clevercoffee/clevercoffee-docs/public/3d-designs/readme.md

Tipps zum Drucken:

1. Gehäuse auf dem Kopf liegend drucken (um 180° in X oder Y drehen)
2. Ein halbwegs Temperaturstabiles Filament verwenden (normales PLA ist etwas knapp)
3. Optimiert für eine 0,4mm Düse und eine Schichthöhe von 0,2mm
4. Für einen schönen optischen Touch in der ersten Schicht conzentrischen Infill verwenden

Die Magneten mit 6mm Durchmesser (2x 1mm und 1x 2mm dick) mit einem guten Kleber einkleben - Sekundenkleber hat sich als ungeeignet herausgestellt. 

Nach der [Einbauanleitung.pdf](./Einbauanleitung.pdf) zusammenbauen und montieren.
