clevercoffee/clevercoffee-docs/src/content/de/intro/requirements.mdx

---
title: Anforderungen an dich
---

# Anforderungen an dich

<Caution lang={props.params.lang} />

## Zentrale Fragen

### Traue ich mir zu mit 230V Spannung zu arbeiten? Ist mir die Gefahr bewusst?

Ihr verändert bzw. erweitert mit dem Einbau die werksseitige 230V-Verkabelung der Maschine. Damit habt ihr immer das Risiko eines lebensgefährlichen Stromschlags oder Feuer, sei es durch Fehler beim Einbau, nicht ausreichend isolierte Kontakte, brüchige Isolierung bei älteren oder nicht ausreichend hitzebeständigen Kabeln, etc. **Das muss euch bewusst sein, ihr macht den Einbau auf eigenes Risiko!**

Wenn ihr das nicht fachlich richtig umsetzen könnt oder unsicher seid, sucht euch bitte jemanden vom Fach! Für jemanden mit Grundwissen in Elektrotechnik ist der Einbau kein Problem. Wir helfen bei konkreten Fragen gerne weiter, aber die Verantwortung für euren Umbau können und wollen wir euch nicht abnehmen!

Eine eventuell noch bestehende Garantie bei neueren Maschinen ist durch den Einbau selbstverständlich erloschen, das muss euch ebenfalls bewusst sein.

### Habe ich Lust dazu, mich näher mit meiner Maschine und mit der PID-Steuerung zu beschäftigen?

Mit der PID-Steuerung erhöht ihr die Komplexität eurer Maschine. Ihr hab jetzt mehr Möglichkeiten, für den Kaffeegenuss relevante Parameter zu verändern als vorher. Das kann viel Freude machen, kann aber auch überfordern, sofern man beim ausprobieren nicht planvoll vorgeht.

Wir haben für die gängigen Einkreiser-Espressomaschinen bereits gut funktionierende Parameter-Setups verfügbar, daher werden sich die Ergebnisse in der Tasse verbessern, auch wenn ihr „nur“ den PID installiert und die Standardparameter aufspielt.

Ihr kommt aber zu noch besseren Ergebnissen, wenn ihr etwas besser Bescheid wisst, was der PID tut und warum er das tut. Es lohnt sich die Zeit zu investieren um a) seine Maschine besser kennen zu lernen und b) die Grundfunktion des PIDs zu verstehen. Außerem lernt man auch eine Menge darüber, wie sich der Geschmack von Espresso bei Anpassung verschiedener Parameter verändert.
