clevercoffee/clevercoffee-docs/src/content/en/hardware/index.md

---
title: Hardware
parent: EN - Manual
asIndexPage: true
---

# Hardware

This part contains the hardware related aspects of the PID, including the test assebly, circuit diagrams and final installation.
