clevercoffee/clevercoffee-docs/src/content/de/index.mdx

## Handbuch (deutsch)

Dies ist das deutsche Handbuch für die Umsetzung des CleverCoffee Projektes. Dieses Handbuch deckt alle notwendigen Schritte für den Einbau und die Konfiguration ab.

Es ist sehr empfehlenswert zuerst die einleitenden Artikel zu lesen. Dadurch erfährt man, welche Anforderungen erfüllt sein müssen, um eine Maschine mit einem PID zu ergänzen. Außerdem wird beschrieben was das vorgestellte System kann (und was es nicht kann).

Der erste konkrete Schritt beginnt mit der Bestellliste. Je nach Ausbaustufe und bereits vorhandener Ausstattung, setzt sich diese unterschiedlich zusammen. Während ihr auf die Hardware wartet, könnt ihr damit beginnen die Software aufzusetzen. Danach wird beides vereint und eingebaut. Nach erfolgreichem Test findet ihr im letzten Abschnitt noch eine Vielzahl von Anpassungsmöglichkeiten, damit auf keinen Fall lange Weile aufkommt.

Mehr zum Projekt findet ihr auf der [CleverCoffee Website](https://clevercoffee.de/).

## Kontakt

Schaut am besten auf unserem [Discord](https://discord.com/invite/Kq5RFznuU4) vorbei.
