clevercoffee/clevercoffee-docs/src/content/de/customization/index.md

---
title: Konfiguration & Anpassung
asIndexPage: true
---

# Konfiguration & Anpassung

In diesem Abschnitt gehen wir auf die Detail ein. Hier seht ihr, welche PID Parameter angepasst werden können und welchen Einfluss die Anpassungen haben. Dieses Kapitel ist damit insbesondere nach dem erfolgreichen Einbau interessant, wenn es nur noch um das Feintuning geht.
