clevercoffee/clevercoffee-docs/src/content/de/intro/index.md

---
title: Einführung
asIndexPage: true
---

# Einführung

In diesem Abschnitt werden die Grundlagen der Funktionen und Möglichkeiten des PIDs und der restlichen Features beschrieben. Es ist damit ein guter Start in das Thema und beschreibt auch nötige Voraussetzungen und Warnhinweise. Zudem wird beschrieben welche Maschinen bereits erfolgreich einen PID-Ausbau erhalten haben und wie der Trockenaufbau aussieht.
