clevercoffee/clevercoffee-docs/src/content/de/intro/intro.md

---
title: Einleitung PID System
---

# Einleitung PID System

## Was bringt mir eine PID-Steuerung?

Eine PID-Regelung ermöglicht es deiner Espressomaschine die Temperatur des Brühwassers sehr viel exakter und konstanter zu regeln als das mit den werksseitig verbauten Bimetall-Thermostaten möglich ist.

Die gängigen Thermostate haben eine Schwankung der durch sie geregelten Temperatur von bis zu 10°, auch Hysterese genannt. Grob gesagt bedeutet das: eure Maschine heizt hoch, bis der Thermostat seine Schalttemperatur erreicht hat und den Strom zur Heizung unterbricht. Gleichzeitig leuchtet die Lampe eurer Maschine auf (bzw. die Heizlampe wird ausgeschaltet) und zeigt euch Brühbereitschaft an.

Jetzt verliert der Kessel eurer Maschine je nach Ausführung mehr oder weniger schnell Wärmeenergie durch Abstrahlung an die Umgebung. Dies geschieht so lange, bis der Anschaltpunkt des Thermostaten erreicht ist und er den Stromkreis zur Heizung wieder aktiviert. Die Brühlampe eurer Maschine erlischt und die Maschine heizt wieder hoch bis zum Erreichen des Abschaltpunktes.

Zwischen diesen beiden Temperaturpunkten leuchtet die ganze Zeit die Brühbereitschaftslampe eurer Maschine. Die wirkliche Brühtemperatur des Wassers kann sich aber entweder ganz unten nah beim Anschaltpunkt des Thermostaten befinden, oder ganz oben kurz vor dem Abschaltpunkt, oder irgendwo im Bereich dazwischen.

Neben guten Bohnen, einer guten Mühle, der richtigen Dosis und dem Mahlgrad ist beim Espresso brühen die Temperatur des Brühwassers einer DER entscheidenden Faktoren für den Geschmack des Kaffees. Schon eine Differenz von 1-2° kann den Unterschied zwischen zu sauer (zu kalt), zu bitter (zu heiß) oder lecker (genau richtig) bedeuten. Welche Temperatur ideal ist hängt neben dem eigenen Geschmack jeweils stark von der verwendeten Bohne und der Röstung ab.

Eine herkömmliche Maßnahme ist das sogenannte Temperatursurfen, eine relativ aufwändige und unsichere manuelle Methode der Temperaturkontrolle, die viel schätzen und immer wieder ausprobieren erfordert.

Viele Nutzer sind davon irgendwann genervt, wir waren es genauso.

Die Lösung für kleinere Einkreiser-Maschinen ist es, den Thermostaten mit einem PID-Regler zu ersetzen. Dieser regelt die Brühtemperatur mit einer Schwankung von deutlich unter 1°, unser System kann auf bis zu 0,1° genau regeln. Man muss nicht mehr an der Maschine bleiben um den richtigen Zeitpunkt zum Bezug abzuwarten, der richtige Zeitpunkt ist ab jetzt einfach immer sobald die Maschine einmal durchgeheizt ist!

## Was kann unser System?

Folgende Eckdaten zeichnen unseren DIY PID aus:

- Regelung der Brühtemperatur mit einer Genauigkeit von bis zu +/- 0,1°
- Steuerung der Brühzeit inkl. Pre-Infusion in der Ausbaustufe „Vollausbau“ möglich
- Bezug nach Gewicht
- Wasserstandmonitor
- Bedienung und Konfiguration über eingebautes Webinterface
- Datenmonitoring alternativ über Grafana (Webbasiert) und MQTT (IoT) möglich
- Updates der Software sind drahtlos über WLAN möglich
- Unsere Software ist OpenSource: für euch kostenfrei und auf persönliche Anforderungen anpassbar
- Geringer Platzbedarf, passt problemlos in die meisten kleineren Espressomaschinen
- Die serienmäßige Verkabelung der Maschine bleibt erhalten und wird nur erweitert. Die Maschine kann nach dem Umbau problemlos wieder zurückgerüstet werden
- Aktive User-Community im Projektchat mit schnellem Support

Anregungen zur Weiterentwicklung der Software werden von uns gerne aufgenommen. User-Input ist immer willkommen und bringt das Projekt weiter!

## Universell – Umgebaute Maschinentypen

Entwickelt wurde unser System ursprünglich an einer Rancilio Silvia, es ist aber universell einsetzbar. Bislang haben unsere User die folgenden Maschinen erfolgreich umgebaut:

- Rancilio Silvia V1 – V4
- Rancilio Silvia E(co) V5 & V6
- Gaggia Classic (9303) / Classic Pro (9480) / New Classic (9403)
- Lelit PL41 / PL42
- La Pavoni EPL / Saeco Aroma
- E61 Einkreiser (Bazzar A1 Livello, Fiorenzato Colombina)
- E61 Zweikreiser (Profitec Pro500)
- Quick Mill Retro (0835) & Orione (3000)

## Aufbau / Unterschiede PID Only vs. Vollausbau

Grundsätzlich besteht unser PID-Regler aus den folgenden Komponenten:

| ID  | Erklärung |
| --- | --- |
| 1 | Mikrocontroller ESP32 (DevKitC V4) |
| 2 | Temperatursensor TSIC 306 |
| 3 | Solid State Relais (SSR) |
| 4 | Netzteil zur Stromversorgung |
| 5 | Display SSD1306 (empfohlen, aber optional) |

Trockenaufbau

Es gibt zwei verschiedene Ausbaustufen unseres Systems: PID Only und den erweiterten Vollausbau.

## Ausbaustufen

Es gibt 2 Ausbaustufen: "PID Only" und den "Vollausbau".
Mit der Zeit haben sich dazu Ergänzungen ergeben, die in der nachfolgenden Grafik dargestellt sind.
Die Grenzen sind fließend, da auch beim "PID Only" nun zur Anzeige des Bezugsgewicht die Waage genutzt werden kann oder die Erkennung des Brühschalters per Optokoppler eine genaue Anzeige der Brühzeit ermöglicht.

Trockenaufbau

## Grundversion (PID Only)

Die Grundversion ist ein klassischer PID-Regler: der Temperatursensor nimmt die aktuelle Temperatur des Kessels auf (Input) und gibt den Wert an die PID-Software auf den Mikrocontroller weiter. Diese gibt dann das Regler-Signal (Output) an das SSR aus, welches die Heizung eurer Maschine aktiviert bzw. deaktiviert.

Damit ist eine exakte Regelung der Brühtemperatur auf euren Wunschwert durch die PID-Software möglich, die restliche Bedienung eurer Maschine bleibt unangetastet. MQTT, Displayausgabe und Webinterface ist auch mit PID Only möglich.

## Erweiterung der Grundversion (PID Only+)

Um bei einem Bezug die Temperatur besser zu regeln, kann ein zusätzlicher Sensor (Optokoppler) verbaut werden, um den Brühschalter abzufragen. Damit kann während des Bezugs auf dem Display die genaue Brühzeit angezeigt werden.

## Vollausbau

Beim Vollausbau gehen wir einen Schritt weiter und überlassen die Ansteuerung der Pumpe und des Magnetventils ebenfalls der Software. Dadurch könnt ihr in der App drei Zeitintervalle vorgeben:

- Pre-Infusion: die Pumpe baut Druck auf (geringer als der Brühdruck) und das Magnetventil gibt das Brühwasser auf den Siebträger

- Pause: die Pumpe pausiert, der aufgebaute Druck bleibt aber durch das geschlossene Magnetventil im Siebträger bestehen. So wird der Kaffeepuck gleichmäßig durchfeuchtet und so kann etwaiges Channeling reduziert werden.

- Brühzeit: jetzt startet der „normale“ Bezug mit der von dir festgelegten Bezugszeit, z. B. 25 Sekunden und vollem Druck. Je nach Bohnensorte und persönlichem Geschmack kann eine kürzere oder längere Bezugszeit den Geschmack des Espressos positiv beeinflussen.

Beim Vollausbau ändert sich die Bedienung eurer Maschine auch etwas: der Brühschalter, mit dem ihr bislang den Bezug gestartet und auch wieder gestoppt habt, dient nun nur noch als Taster, der den automatisierten Bezug startet. Gestoppt wird der Bezug durch die Software, auch wenn der Schalter noch auf ON steht.

Unsere Empfehlung, basierend auf unseren eigenen Erfahrungen und denen der bislang mehr als 250 User des PIDs, lautet ganz klar, zuerst die Grundversion PID Only umzusetzen. Damit ist die größte geschmackliche Verbesserung im Vergleich zum vorherigen Serienzustand eurer Maschine zu erwarten. Der Vollausbau ist darauf aufbauend eine Erweiterung der Möglichkeiten, aber gleichzeitig auch ein komplexerer Umbau.

## Vollausbau Plus

Bei diesem Ausbau bleibt kein Wunsch mehr offen, da das Bezugsgewicht nun die Bezugsdauer steuert.
Auch ist eine Drucküberwachung mittel Drucksensor möglich (aber kein Pressure Profiling).
