clevercoffee/clevercoffee-docs/src/content/de/pcb/index.md

---
title: Platinen
asIndexPage: true
---

# Platinen

Um den Einstieg in CleverCoffee zu vereinfachen haben wir Platinen (PCBs) entwickelt auf die ein ESP32 Entwicklerboard aufgesteckt werden kann.
Die Platine stellt euch dann alle benötigten Anschlüsse bereit und passt zur Belegung der GPIOs in unserer Software.

Die Entwicklung findet in einem extra Repository statt. Ihr findet dieses hier: [CleverCoffee Hardware Repository](https://github.com/rancilio-pid/clevercoffee-hardware).

In diesem Abschnitt befinden sich alle Informationen zu den Platinen und den verschiedenen Revisionen.
