clevercoffee/clevercoffee-docs/src/content/de/software-part-I/index.md

---
title: Software
asIndexPage: true
---

# Software

## Einleitung

In diesem Kapitel wird beschrieben wie der Code auf den Mikrocontroller (ESP32 oder ESP8266) geladen wird. Damit könnt ihr loslegen, sobald ihr den Mikrocontroller zur Hand habt (weitere Teile werden hierfür noch nicht benötigt). Für einen Test sollte dann zumindest der Temperatursensor angeschlossen werden.
