clevercoffee/clevercoffee-docs/src/content/en/intro/index.md

---
title: Introduction
parent: EN - Manual
asIndexPage: true
---

# Introduction

This section covers the basics, functionality as well as options of the PID. It will get you grounded in the topic and covers prerequisites as well as warnings. It provides information about models of espresso machines that have already been modified and how the general setup looks like.
