clevercoffee/clevercoffee-docs/src/content/en/software-part-I/index.md

---
title: Software
parent: EN - Manual
asIndexPage: true
---

# Software

## Introduction

In this section, all steps are described on how to load the code onto the microcontroller (ESP32 or ESP8266). With that, you can already get started without having the other hardware parts at hand. You can start with this part while waiting for your ordered parts to be delivered ;)
