clevercoffee/clevercoffee-docs/src/content/de/bauberichte/lelit-pl41em.md

---
title: Lelit PL41EM / PID-Only
---

# Lelit PL41EM / PID-Only

<!-- ## Bestellliste

*todo* -->

<!-- markdown-link-check-disable -->

## Trockenaufbau

Auf dem Bild unten seht ihr den von mir vorbereiteten Trockenaufbau, den ich vor dem Einbau getestet habe. Wie hier im Handbuch ausgiebig erklärt, habe ich die Terminals an die Platine des NodeMCU gelötet, die Software aufgespielt, hitzebeständige Litzen an den Temperatursensor gelötet und mit Schrumpfschlauch versehen, das Display (vorläufig) angeschlossen, das Netzteil vorbereitet und das Relais angeschlossen und getestet. Wichtig war für mich vor dem Einbau, dass die Softwareupdates over-the-air funktionieren, sodass ich bei zukünftigen Updates die Maschine öffnen muss. Als das alles zufriedenstellend funktionierte, habe ich mich an den Einbau in die Maschine gemacht.



## Einbauschritte

### Vorbereitung der Maschine

Zuerst muss die Maschine natürlich vom Strom getrennt und der Wassertank entfernt werden.



Da die Maschine insgesamt recht kompakt und im Inneren dementsprechend wenig Platz für alle PID-Komponenten ist, habe ich mich entschieden, den leeren Raum zwischen Wassertank und Front der Maschine zu verwenden und alle Komponenten dort mit doppelseitigem wärmeleitenden Klebeband zu befestigen. Der Vorteil dieser Anbringung ist, dass die Komponenten weit genug entfernt vom warmen Kessel liegen und ihre Abwärme über die metallische Front der Maschine abgeben können. Der Nachteil allerdings ist, dass eine spätere Fehlersuche nur sehr schwierig ist, da man die Komponenten kaum erreicht und man schlimmstenfalls Platine, Relais und Netzteil komplett ausbauen muss, um eventuell auftretende Fehler zu finden.



Um an das Innere der Maschine zu gelangen, müssen die beiden Schrauben links und rechts neben der Aussparung für die Wasserschläuche herausgedreht und die Tassenablage vorsichtig abgenommen werden. Dabei sollte man natürlich darauf achten, dass die Schläuche nicht durch die teilweise sehr scharfen Metallkanten beschädigt werden.



Ist die Tassenablage entfernt, habt ihr das Innere der Maschine mit Pumpe, Kessel, Elektrik, etc. vor euch und der eigentliche Einbau kann beginnen.



### Netzteil

Um das System mit Strom zu versorgen, müssen Außen-, Neutral- und Schutzleiter der Maschine angezapft werden. Zur besseren Übersicht habe ich mir analog zu den Standardfarben hitzebeständige 1,5mm²-Litzen in braun, blau und grün-gelb gekauft und damit das Netzteil in der Maschine versorgt.




#### Schutzleiter

Die Erdung ist innerhalb der Maschine direkt am Kessel zu finden.


Mit einer Ratsche und einem Inbusbit plus Verlängerung habe ich diese Schraube und die dazu passende Mutter am Brühkopf gelöst und einen passenden Kabelschuh auf die grün-gelbe Litze gecrimpt.




Diesen Kabelschuh habe ich dann auf die Schraube geschoben und sie wieder am Kessel befestigt.



#### Außen- und Neutralleiter

Ich habe mich entschieden, die Stromversorgung für das PID-System hinter dem Hauptschalter der Maschine abzugreifen, sodass das System mit der Maschine an- und wieder ausgeschaltet wird. Die Ausgänge des Schalters sind die beiden _unteren_ Anschlüsse. Um sie anzuschließen habe ich im ersten Schritt Kabelschuhe an eine blaue und eine braune 1,5mm²-Litze gecrimpt.

Da die Ausgänge des Schalters als Flachstecker ausgeführt sind, habe ich sie jeweils mit Flachsteckerverteilern versehen und die zum Netzteil führenden Litzen sowie die Stecker, die ursprünglich angeschlossen waren und den Rest der Maschine mit Strom versorgen, aufgesteckt.






#### Kürzen der Litzen

Im letzten das Netzteil betreffenden Schritt habe ich die drei zum Netzteil führenden Litzen auf die endgültige Länge eingekürzt, mit blauen Kabelschuhen versehen und am Netzteil angeschlossen.






#### Test und Prüfen der Ausgangsspannung

Um den Anschluss des Netzteils zu testen, habe ich die Kaffeemaschine wieder angesteckt, angeschaltet, und mit dem Multimeter die Spannung am Ausgang des Netzteils gemessen. Solltet ihr es nicht schon vorher im Rahmen eures Trockenaufbaus überprüft haben, könnt ihr die Ausgangsspannung des Netzteils mithilfe des Drehpotentiometers auf 5V einstellen.




### Display

Um das Display anzuschließen, habe ich mir von einer Rolle Flachbandkabel die passende Länge (ca. 30--40cm) abgetrennt, vier zusammenhängende Litzen abgelöst, jeweils an einem Ende mit Dupont-Buchsen versehen und diese vier Buchsen in das passende Vierergehäuse geschoben. Hierbei sollte man natürlich auf die korrekte Reihenfolge achten, sodass man sich nicht mit Kabeldrehern an der Platine behelfen muss.







### Vorbereitung Relais

Um das Relais vorzubereiten, müssen in diesem Schritt lediglich die Litzen (ich habe mich für schwarz und blau entschieden) eingekürzt und mit blauen Flachsteckern versehen werden. Der Verteiler, der auf dem Bild an der schwarzen Litze zu sehen ist, ist im Einbau nicht nötig.




### Anbringen der Komponenten in der Maschine

Um die Komponenten in der Maschine anzubringen, habe ich zuerst doppelseitiges, wärmeleitendes Klebeband an Relais und Netzteil angebracht.




Da diese Art des Einbaus im Freiraum zwischen Wassertank und Front der Maschine es kaum erlaubt, nach dem Anbringen noch Kabel an- oder abzuschließen oder überhaupt gut Relais, NodeMCU oder Netzteil zu erreichen, sollte man sich an dieser Stelle sicher sein, dass alle Verbindungen stabil sind, es gar keinen bis kaum Kabelsalat gibt und dass der Aufbau zufriedenstellend funktioniert. Wenn man auf Nummer sicher gehen will, kann man natürlich an dieser Stelle noch einmal einen Test vornehmen, die Espressomaschine anschalten, prüfen, ob das Display des NodeMCU sich anschaltet und ob die Messung des Temperatursensors sinnvoll erscheint.

Ist man sich sicher, dass alles funktioniert, können die Komponenten jetzt in sicherem Abstand voneinander in den Freiraum geklebt und die Kabel verlegt werden. Das Displaykabel sollte natürlich (vorerst) nach außen führen, die Anschlüsse des Relais und der Temperatursensor nach innen in die Maschine.





### Thermostat und Temperatursensor

Um den Temperatursensor am Kessel zu fixieren, habe ich zuerst die am 94°-Thermostat angeschlossenen Kabel gelöst und es mit einem 17er-Schlüssel ausgeschraubt. Darunter kommt ein M4-Gewinde zum Vorschein.





In dieses Gewinde habe ich erst einmal locker eine M4-Schraube mit einer Unterlegscheibe geschraubt. Um den Temperatursensor selbst vorzubereiten, habe ich großzügig wärmeleitenden Kleber auf eine Unterseite gegeben, ihn unter die Unterlegscheibe geschoben und vorsichtig solange die Schraube angezogen, bis der Sensor nicht mehr verrutschte. Dafür bietet es sich an, sich noch ein, zwei helfende Hände zu suchen, um gleichzeitig Sensor, Unterlegscheibe und Schraubendreher unter Kontrolle zu halten. Es ist natürlich sehr wichtig, die Schraube nicht zu fest anzuziehen, um den Sensor nicht zu beschädigen.




### Anschluss Relais

Der Anschluss des Relais besteht nun einfach daraus, die beiden vom Thermostat abgesteckten Buchsen (eine ist eine einfache Buchse, die andere ist ein Verteiler) auf die Flachstecker der Ausgangslitzen des Relais zu stecken. Welchen Ausgang des Relais man mit welchem Stecker verbindet, ist an dieser Stelle egal, da das Relais auf Anweisung unabhängig von irgendwelcher Polung einfach eine Verbindung zwischen seinen beiden Ausgängen herstellt.



### Einbau Schutzplatte

Wenn alles angeschlossen und man sich vom korrekten Funktionieren des ganzen Systems überzeugt hat, kann die Tassenablage wieder vorsichtig auf die Maschine gesetzt werden.



Um die nun im inneren der Maschine frei liegende Elektronik zu schützen, habe ich eine [Abdeckplatte](/../../3d-designs/lelit_schutzplatte.scad)[^1] entworfen und gedruckt. Sie lässt sich mittels der Schrauben der Tassenablage fixieren, verdeckt die Elektronik und schützt sie vor eventuellen Wasserspritzern beim Befüllen oder vor Stößen beim Einsetzen des Wassertanks. Leider hat mein 3D-Drucker beim ersten Druck der Platte kein schönes Ergebnis erzeugt, sodass ich die Platte mit ein wenig Gaffer-Tape stabilisieren musste. Gedruckt habe ich die Platte aus PET-G, sodass sie gegenüber einem Druck mit PLA noch ein wenig temperaturunempfindlicher ist.



Wie der Blick von oben in die fertige Maschine zeigt, verschwindet die Elektronikkomplett hinter der Abdeckplatte und es ist noch mehr als genug Platz für den Wassertank.




Um das Display bis zur Umsetzung einer dauerhaften Lösung zu schützen, habe ich dafür ein einfaches Gehäuse gedruckt.

## PID-Werte

Mit den von mir gewählten PID-Werten bin ich noch nicht komplett zufrieden, da es z.B. nach einem kurzen Bezug noch zu recht starken Überschwingern kommt. Für den Kaltstart habe ich die Werte *50/125/0* gewählt, für den anschließenden Betrieb *20/600/0*.

[^1]: Zur Verwendung des [OpenSCAD](https://openscad.org/)-Designs ist noch dieses [Library](https://github.com/openscad/MCAD) notwendig.

<!-- markdown-link-check-enable-->
