clevercoffee/clevercoffee-docs/src/content/de/hardware/index.md

---
title: Hardware
asIndexPage: true
---

# Hardware

In diesem Abschnitt werden alle Hardware-Aspekte behandelt. Dies umfasst den Trockenaufbau, die verschiedenen Schaltpläne und den konkreten Einbau.
