clevercoffee/clevercoffee-docs/public/schaltplan/OnlyPIDRancilio.png

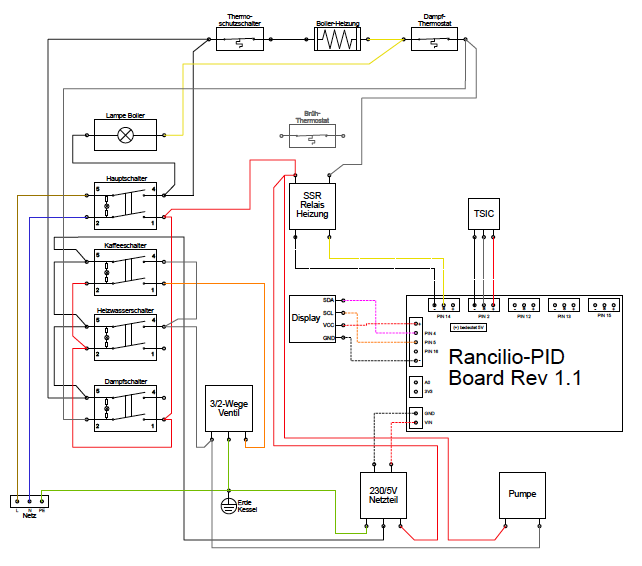
public/schaltplan/OnlyPIDRancilio.png
