clevercoffee/clevercoffee-docs/public/schaltplan/OrginalSchaltplanRancilio.png

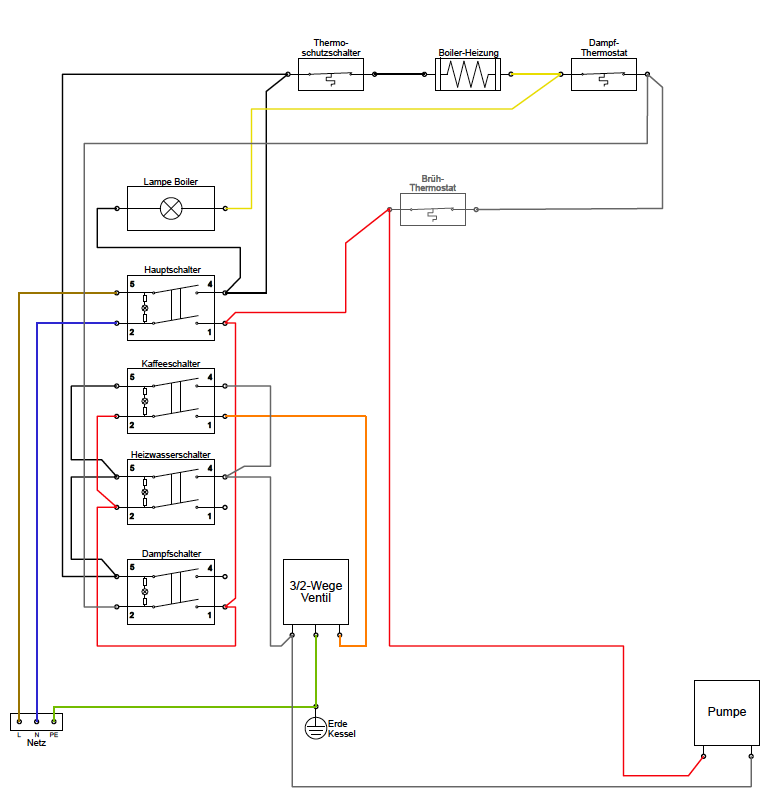
public/schaltplan/OrginalSchaltplanRancilio.png
