clevercoffee/clevercoffee-docs/public/schaltplan/QM_Electrica_Scheme_Quickmill_3000.gif

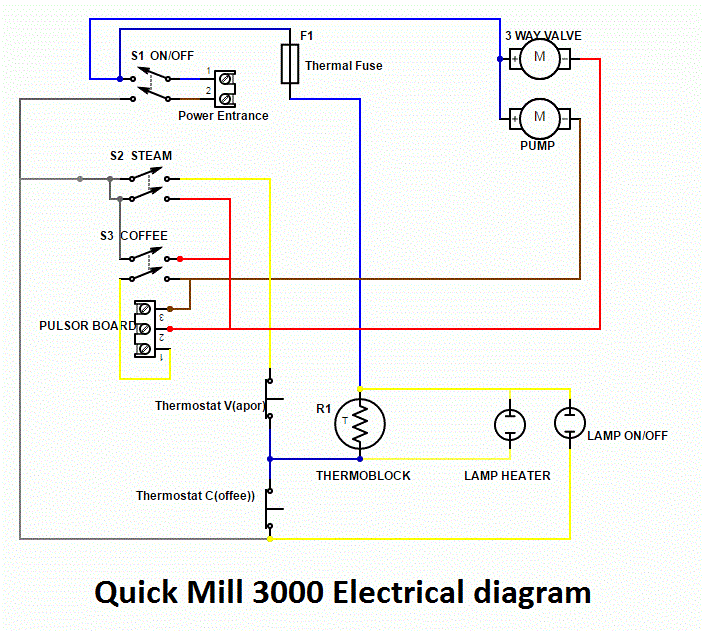
public/schaltplan/QM_Electrica_Scheme_Quickmill_3000.gif
