clevercoffee/clevercoffee-docs/public/schaltplan/QM_Electrica_Scheme_Quickmill_3000_mod1.jpg

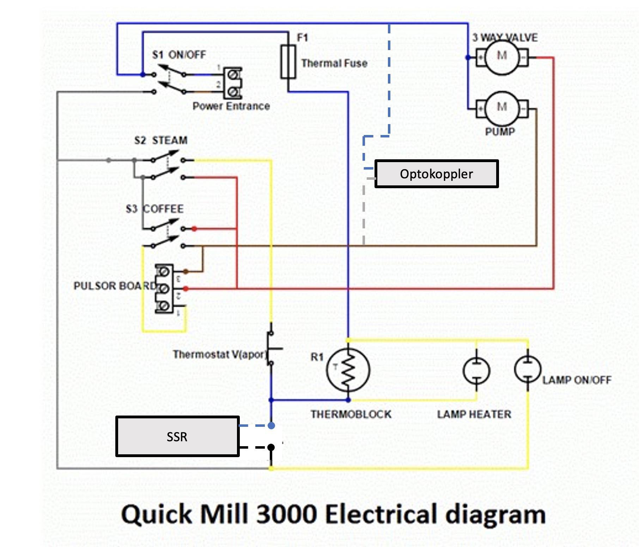
public/schaltplan/QM_Electrica_Scheme_Quickmill_3000_mod1.jpg
