clevercoffee/clevercoffee-docs/public/schaltplan/VollausbauRancilio.png

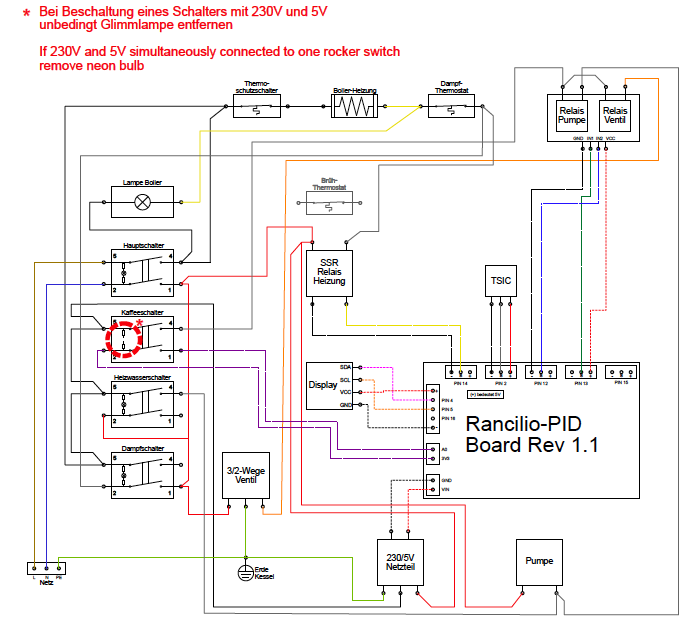
public/schaltplan/VollausbauRancilio.png
