clevercoffee/clevercoffee-docs/public/wp-content/uploads/2021/01/App.jpg

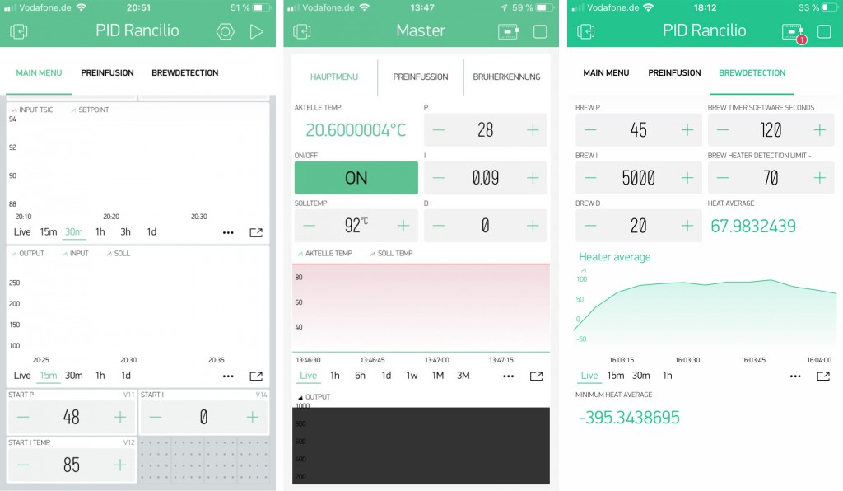
public/wp-content/uploads/2021/01/App.jpg
