clevercoffee/clevercoffee-docs/public/wp-content/uploads/2021/01/Board.jpg

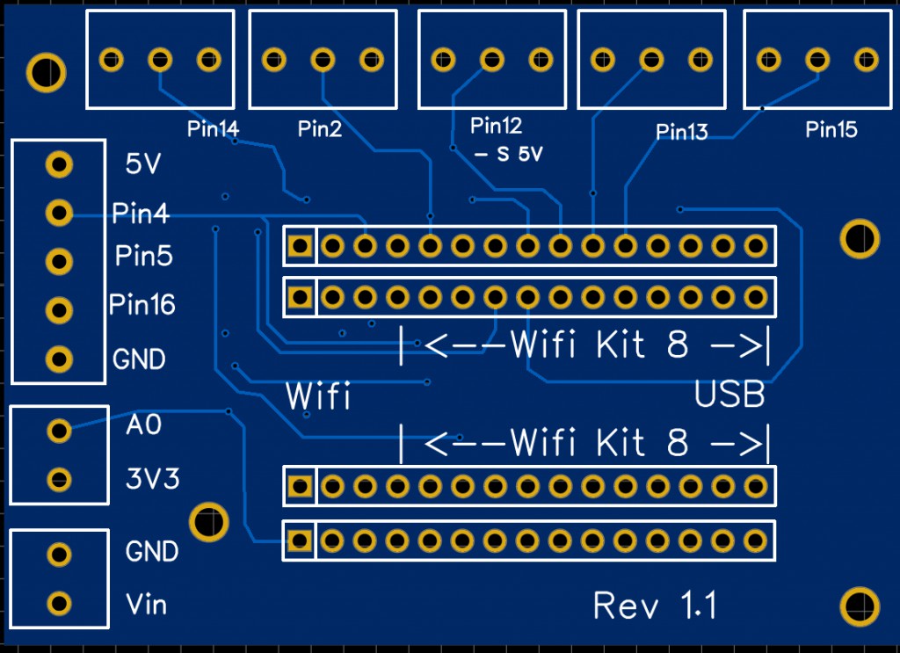
public/wp-content/uploads/2021/01/Board.jpg
