clevercoffee/clevercoffee-docs/public/wp-content/uploads/2021/01/IMG_0099-4-720x960.jpg

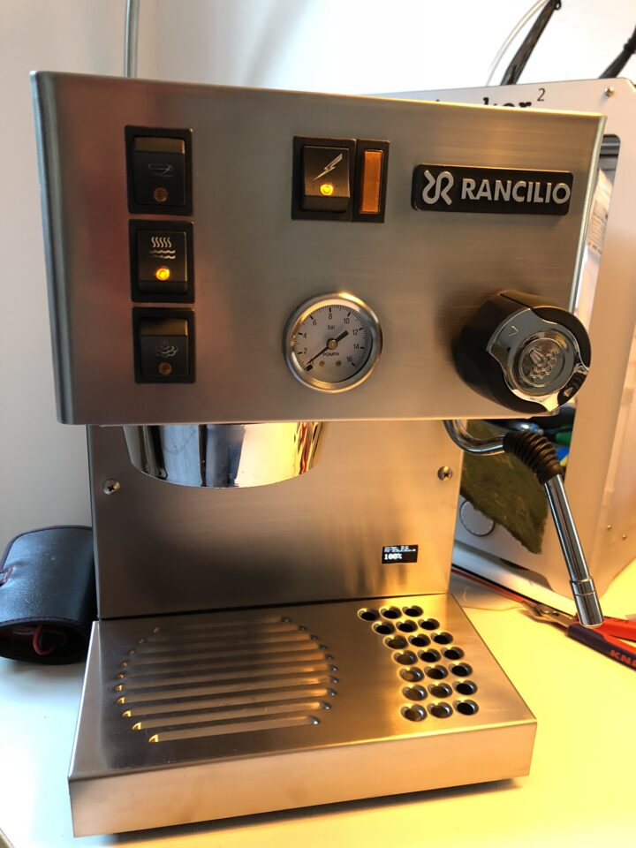
public/wp-content/uploads/2021/01/IMG_0099-4-720x960.jpg
