clevercoffee/clevercoffee-docs/public/wp-content/uploads/2021/01/PID-allgemein-1024x683.jpg

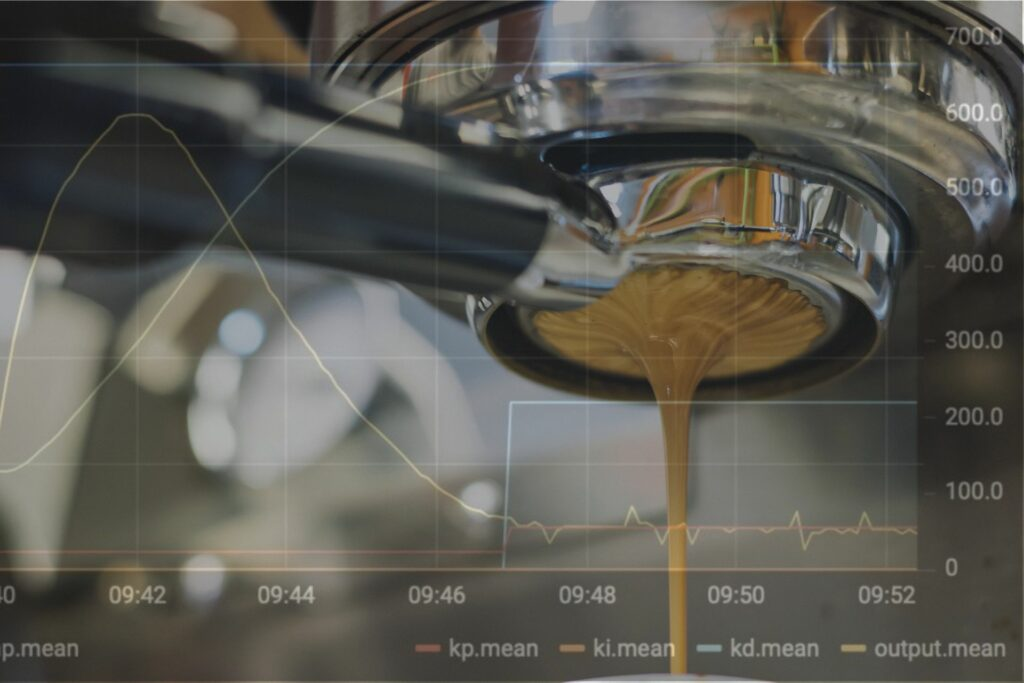
public/wp-content/uploads/2021/01/PID-allgemein-1024x683.jpg
