clevercoffee/clevercoffee-docs/public/wp-content/uploads/2021/03/Bodenschraube-lockern.jpeg

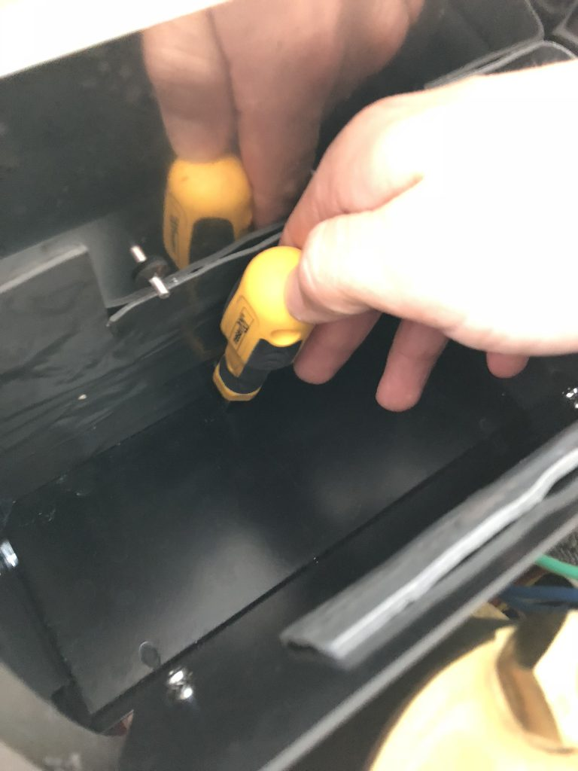
public/wp-content/uploads/2021/03/Bodenschraube-lockern.jpeg
