clevercoffee/clevercoffee-docs/public/wp-content/uploads/2021/03/Frontblech-abschrauben.jpeg

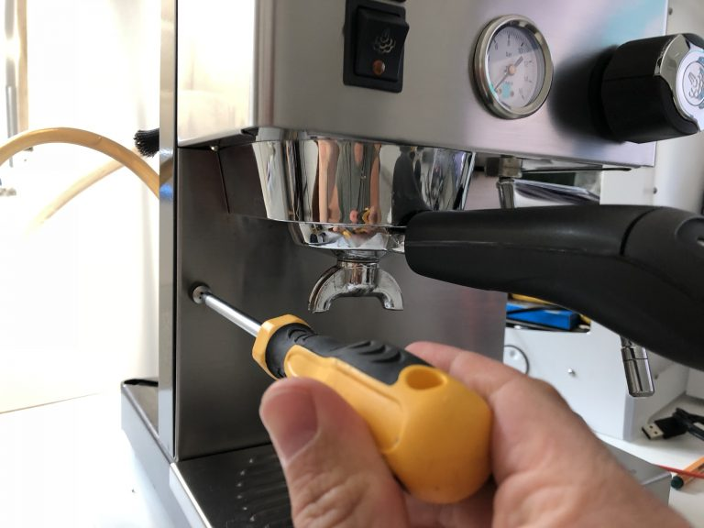
public/wp-content/uploads/2021/03/Frontblech-abschrauben.jpeg
