clevercoffee/clevercoffee-docs/public/wp-content/uploads/2021/03/Frontblech-entnehmen.jpeg

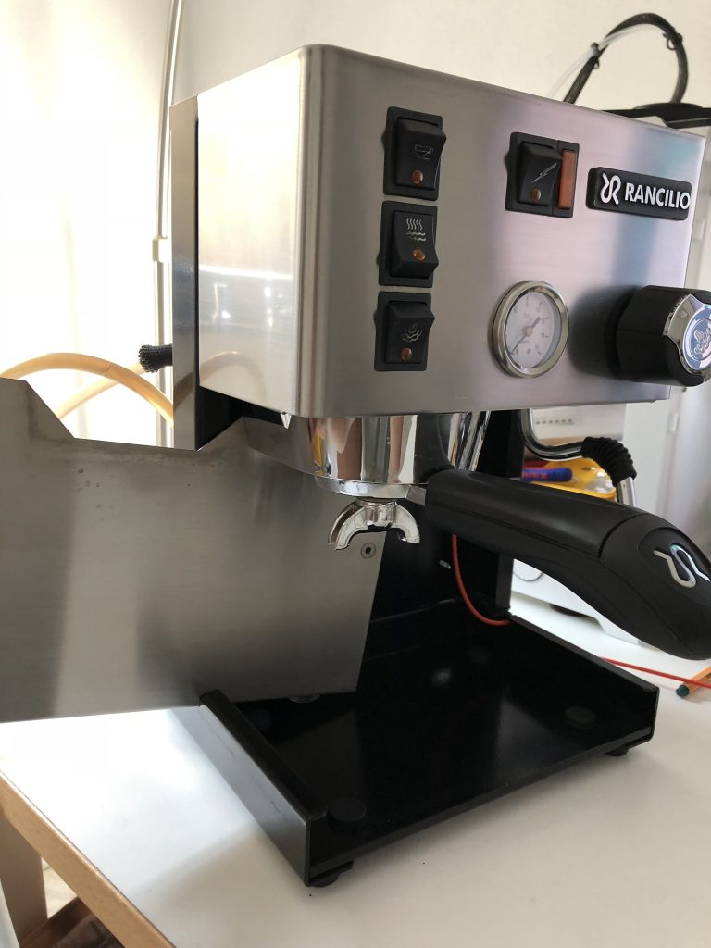
public/wp-content/uploads/2021/03/Frontblech-entnehmen.jpeg
