clevercoffee/clevercoffee-docs/public/wp-content/uploads/2021/03/Kommentierter-Schaltplan-Silvia-E-1024x694.jpg

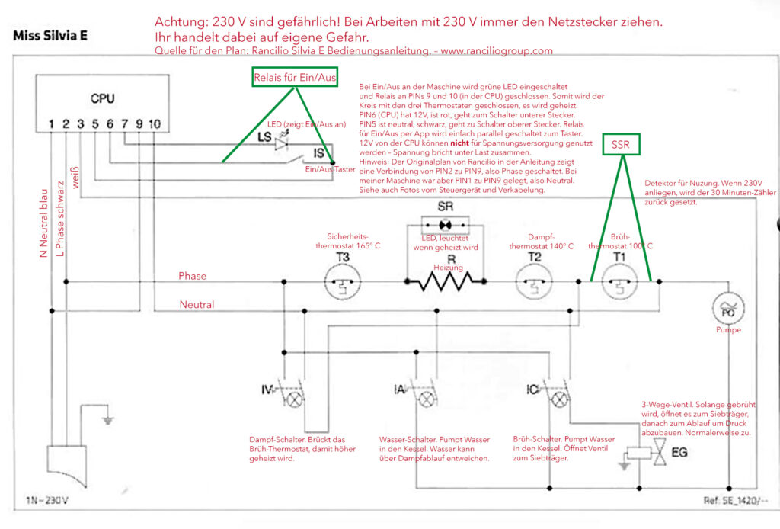
public/wp-content/uploads/2021/03/Kommentierter-Schaltplan-Silvia-E-1024x694.jpg
