clevercoffee/clevercoffee-docs/public/wp-content/uploads/2021/03/Rueckwand-herausnehmen.jpeg

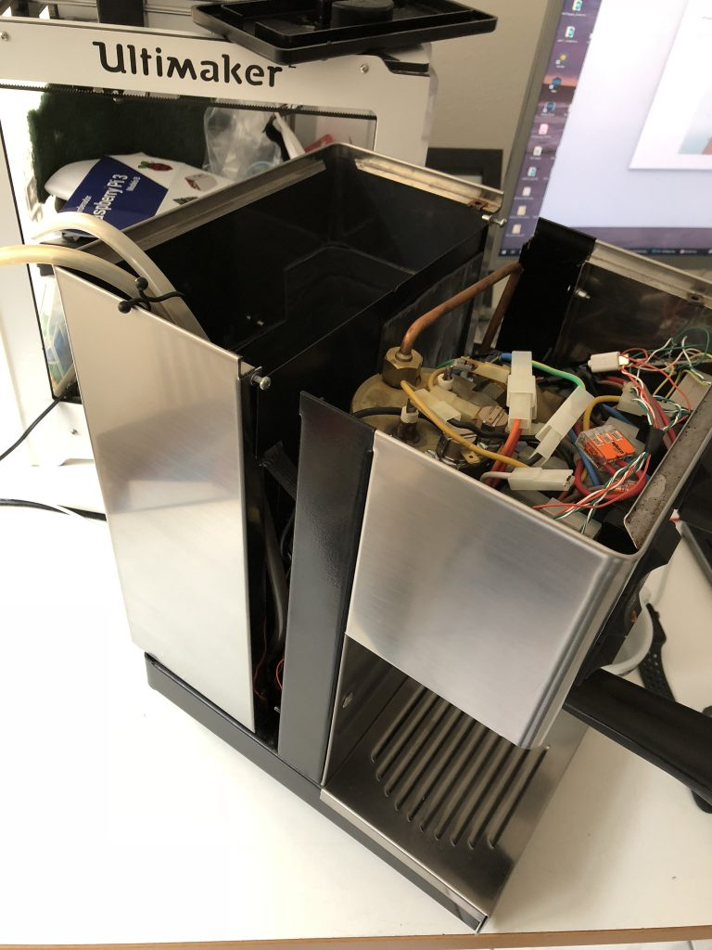
public/wp-content/uploads/2021/03/Rueckwand-herausnehmen.jpeg
