clevercoffee/clevercoffee-docs/public/wp-content/uploads/2021/03/Rueckwandschraube-lockern.jpeg

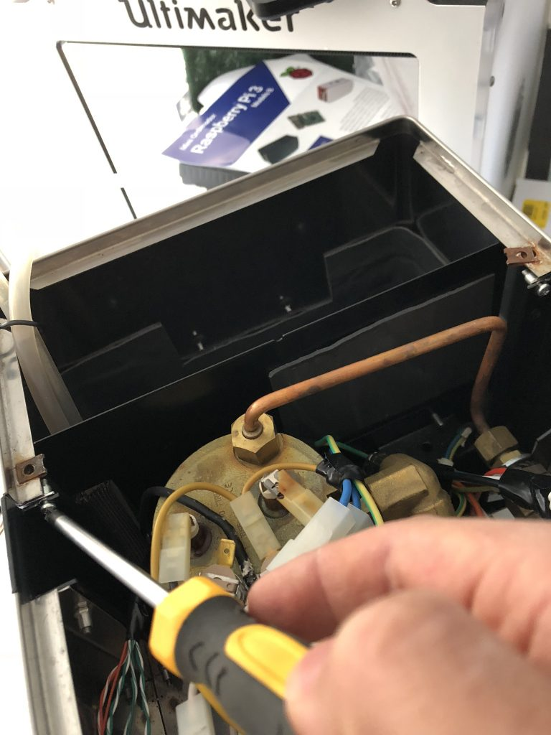
public/wp-content/uploads/2021/03/Rueckwandschraube-lockern.jpeg
