clevercoffee/clevercoffee-docs/public/wp-content/uploads/2021/03/Silvia-E-11-720x960.jpg

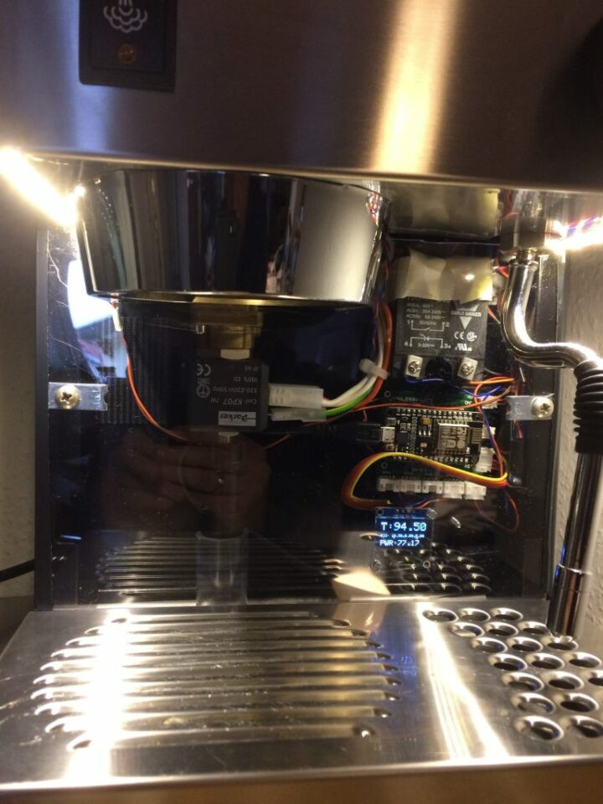
public/wp-content/uploads/2021/03/Silvia-E-11-720x960.jpg
