clevercoffee/clevercoffee-docs/public/wp-content/uploads/2021/03/Silvia-E-36-360x360.jpg

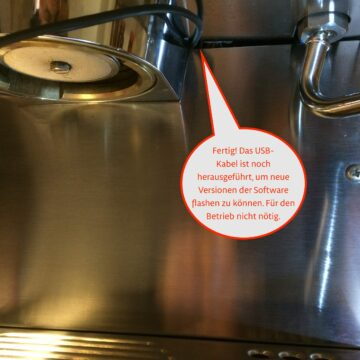
public/wp-content/uploads/2021/03/Silvia-E-36-360x360.jpg
