clevercoffee/clevercoffee-docs/public/wp-content/uploads/2021/03/Tankentnahme.jpeg

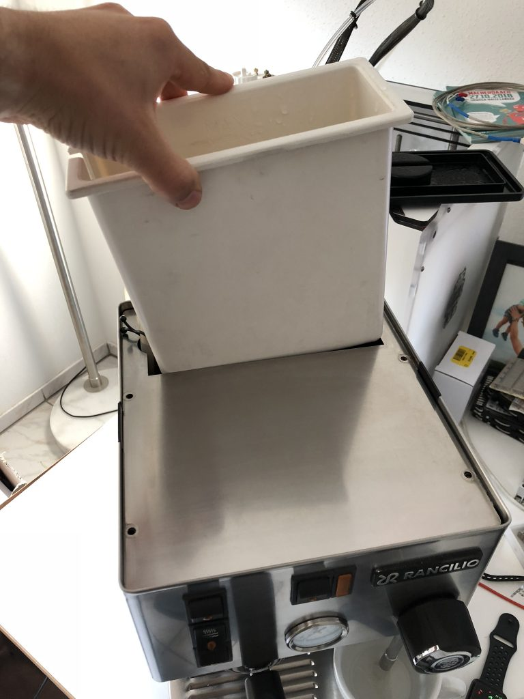
public/wp-content/uploads/2021/03/Tankentnahme.jpeg
