clevercoffee/clevercoffee-docs/public/wp-content/uploads/2021/03/Tassenablage-Entfernen.jpeg

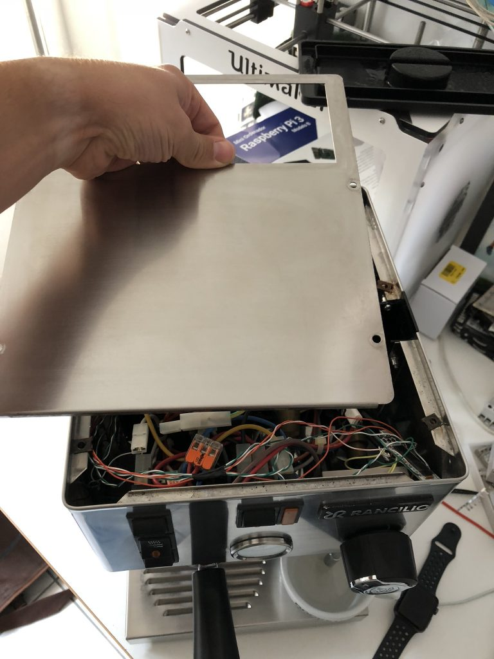
public/wp-content/uploads/2021/03/Tassenablage-Entfernen.jpeg
