clevercoffee/clevercoffee-docs/public/wp-content/uploads/2021/03/Wassertank-Blech-abschrauben.jpeg

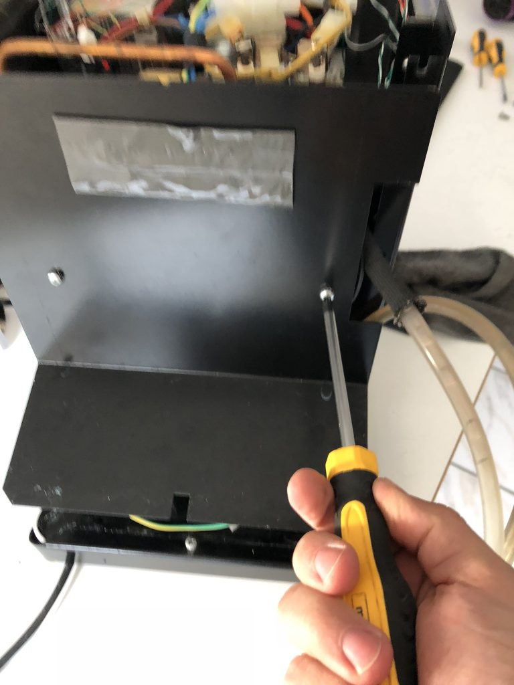
public/wp-content/uploads/2021/03/Wassertank-Blech-abschrauben.jpeg
