clevercoffee/clevercoffee-docs/public/wp-content/uploads/2021/04/2021-04-08-02.39.46-1.jpg

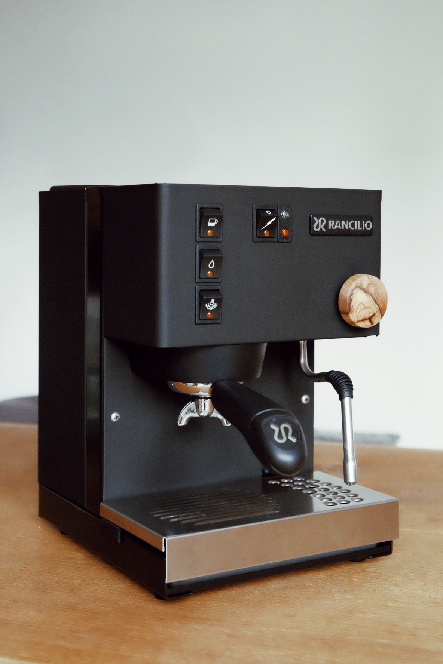
public/wp-content/uploads/2021/04/2021-04-08-02.39.46-1.jpg
