clevercoffee/clevercoffee-docs/public/wp-content/uploads/2021/04/IMG_20210302_221509.jpg

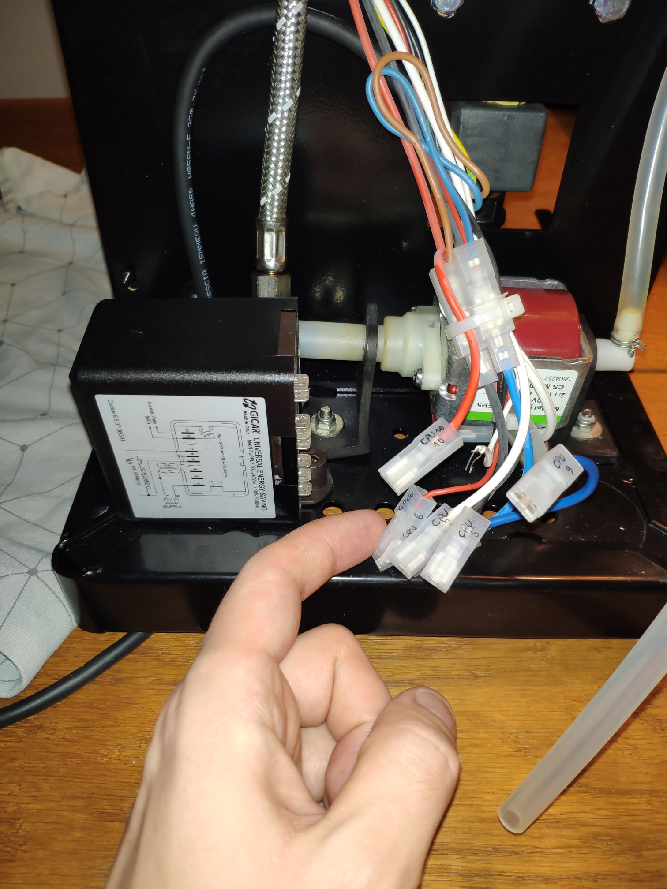
public/wp-content/uploads/2021/04/IMG_20210302_221509.jpg
