clevercoffee/clevercoffee-docs/public/wp-content/uploads/2021/04/IMG_20210303_210453.jpg

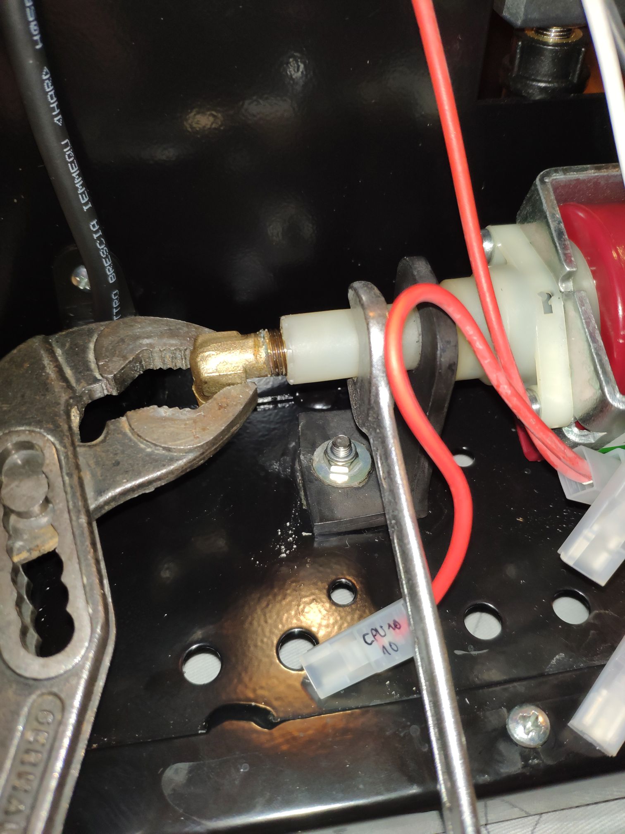
public/wp-content/uploads/2021/04/IMG_20210303_210453.jpg
