clevercoffee/clevercoffee-docs/public/wp-content/uploads/2021/04/IMG_20210303_212256.jpg

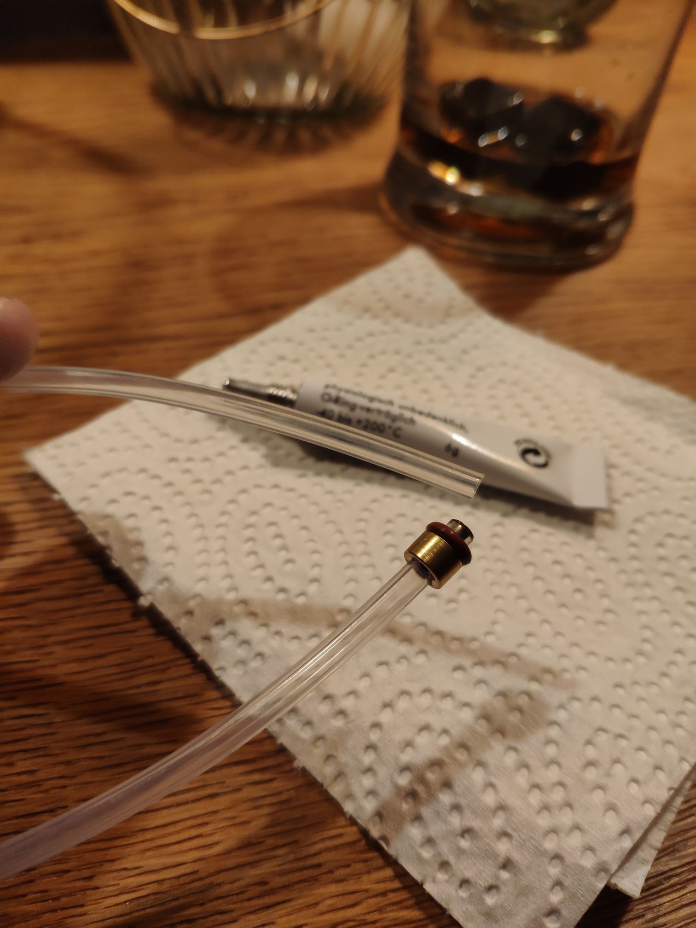
public/wp-content/uploads/2021/04/IMG_20210303_212256.jpg
