clevercoffee/clevercoffee-docs/public/wp-content/uploads/2021/04/IMG_20210310_210014.jpg

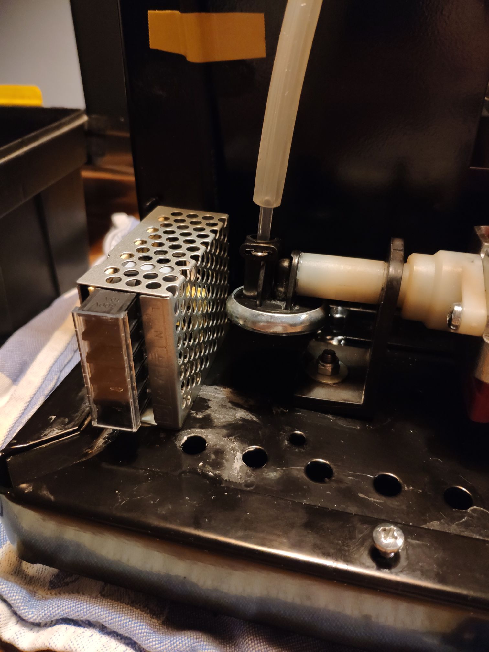
public/wp-content/uploads/2021/04/IMG_20210310_210014.jpg
