clevercoffee/clevercoffee-docs/public/wp-content/uploads/2021/04/IMG_20210314_214001.jpg

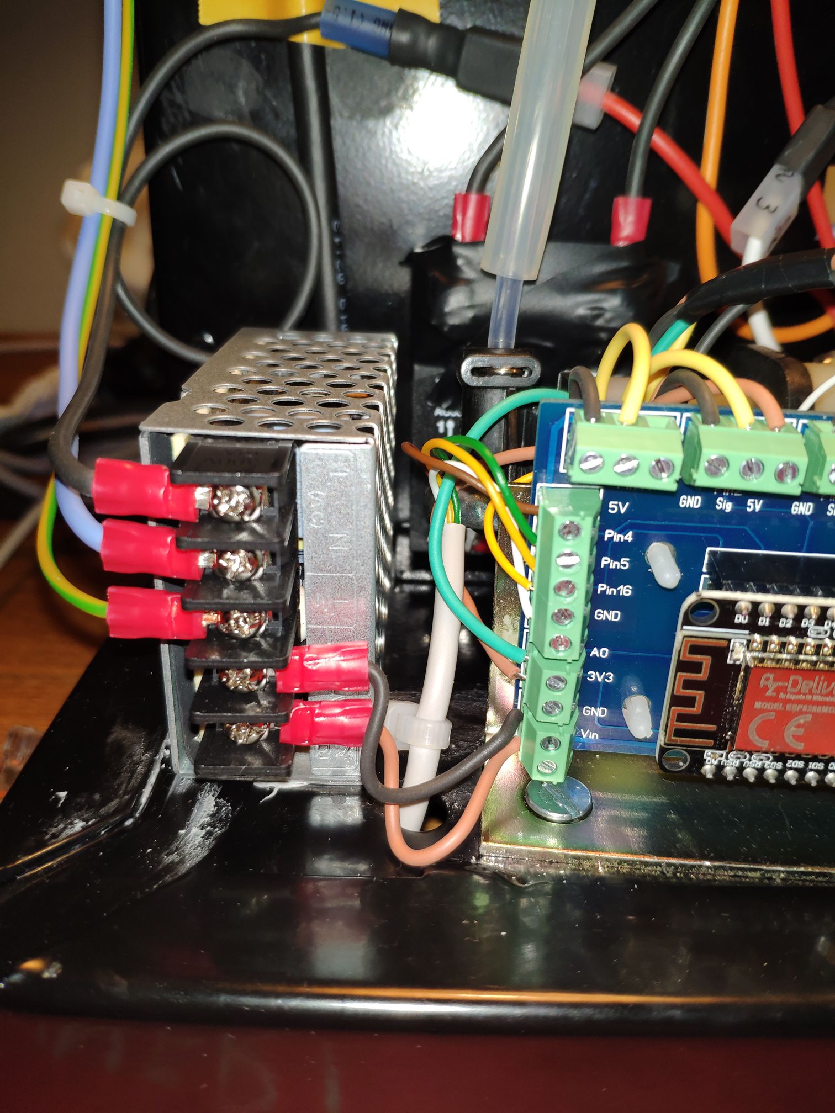
public/wp-content/uploads/2021/04/IMG_20210314_214001.jpg
