clevercoffee/clevercoffee-docs/public/wp-content/uploads/2021/04/IMG_20210314_215531.jpg

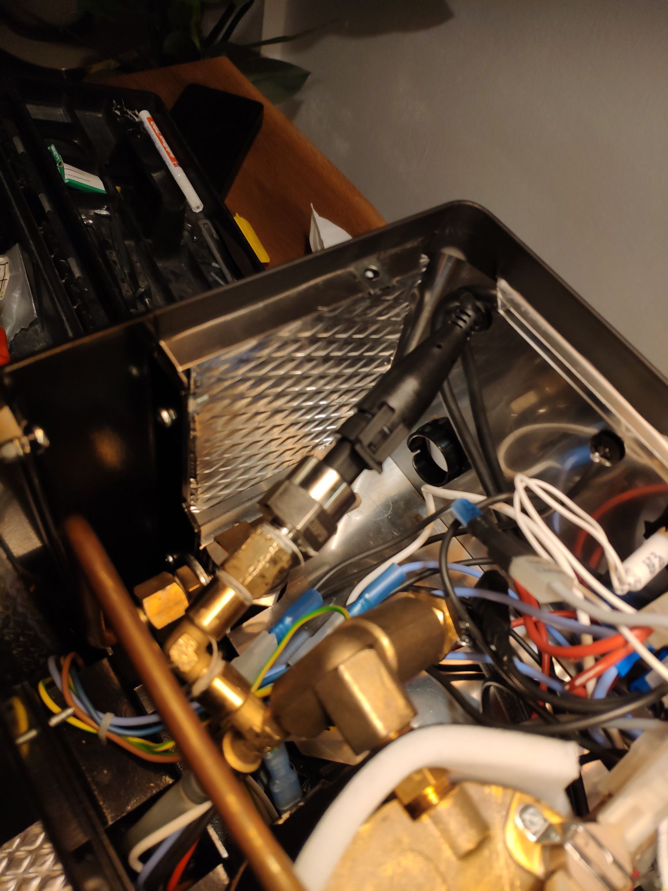
public/wp-content/uploads/2021/04/IMG_20210314_215531.jpg
