clevercoffee/clevercoffee-docs/public/wp-content/uploads/2021/04/IMG_20210404_150609.jpg

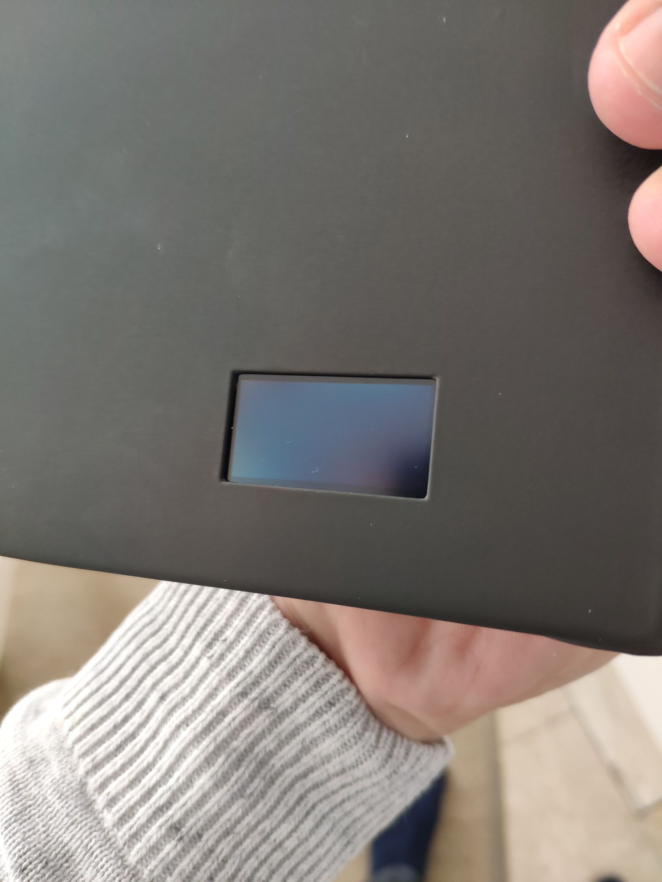
public/wp-content/uploads/2021/04/IMG_20210404_150609.jpg
