clevercoffee/clevercoffee-docs/public/wp-content/uploads/2021/04/IMG_20210404_151123.jpg

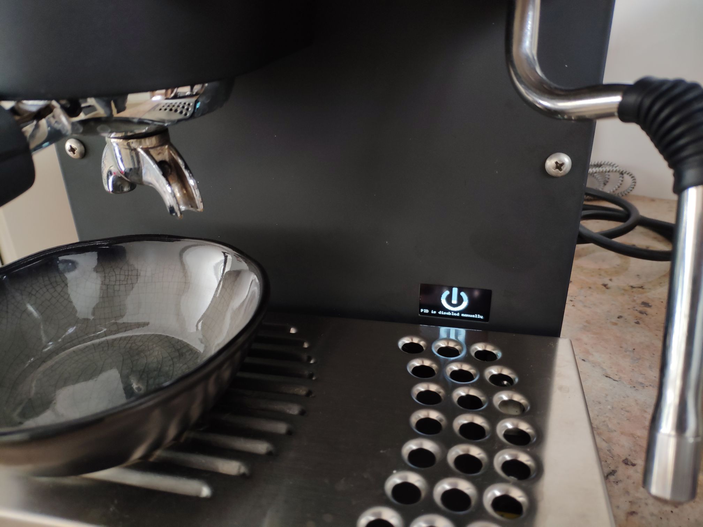
public/wp-content/uploads/2021/04/IMG_20210404_151123.jpg
