clevercoffee/clevercoffee-docs/public/wp-content/uploads/2021/04/IMG_20210408_145907-720x720.jpg

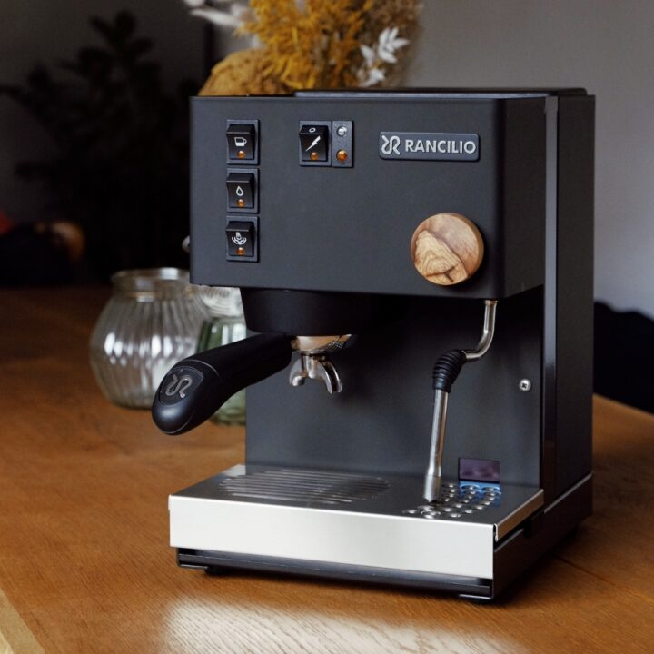
public/wp-content/uploads/2021/04/IMG_20210408_145907-720x720.jpg
