clevercoffee/clevercoffee-docs/public/wp-content/uploads/2021/04/Schaltplan-Silvia-E-Schalter.png

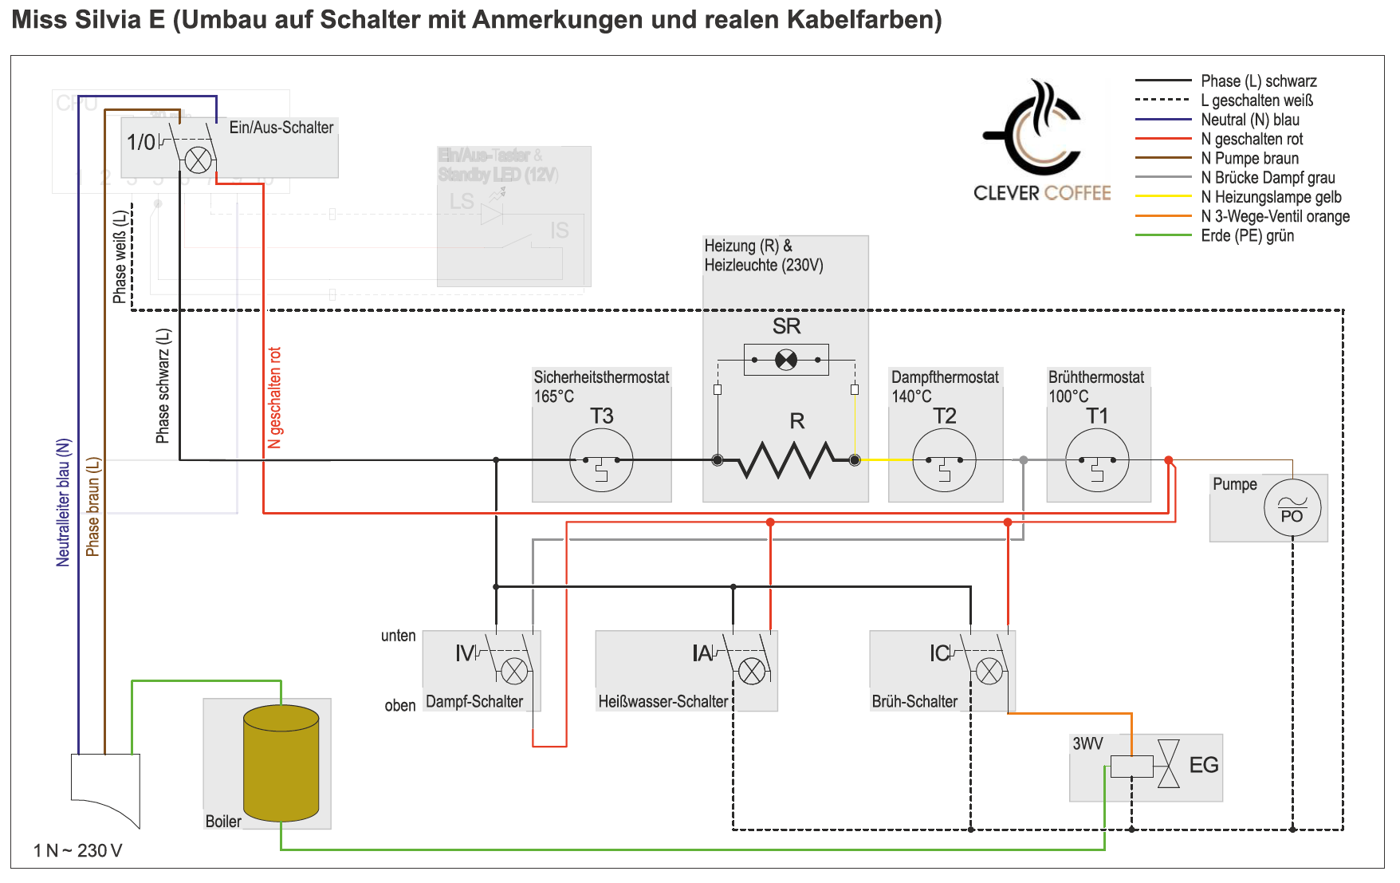
public/wp-content/uploads/2021/04/Schaltplan-Silvia-E-Schalter.png
