clevercoffee/clevercoffee-docs/public/wp-content/uploads/2021/04/Schaltplan-Silvia-E-Vollausbau-5V-1024x648.png

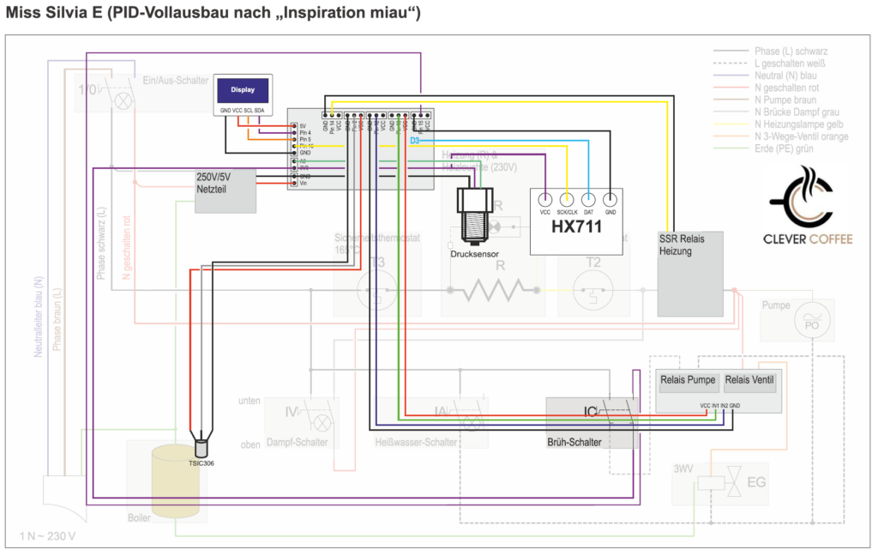
public/wp-content/uploads/2021/04/Schaltplan-Silvia-E-Vollausbau-5V-1024x648.png
