clevercoffee/clevercoffee-docs/public/wp-content/uploads/2021/04/Software_3.png

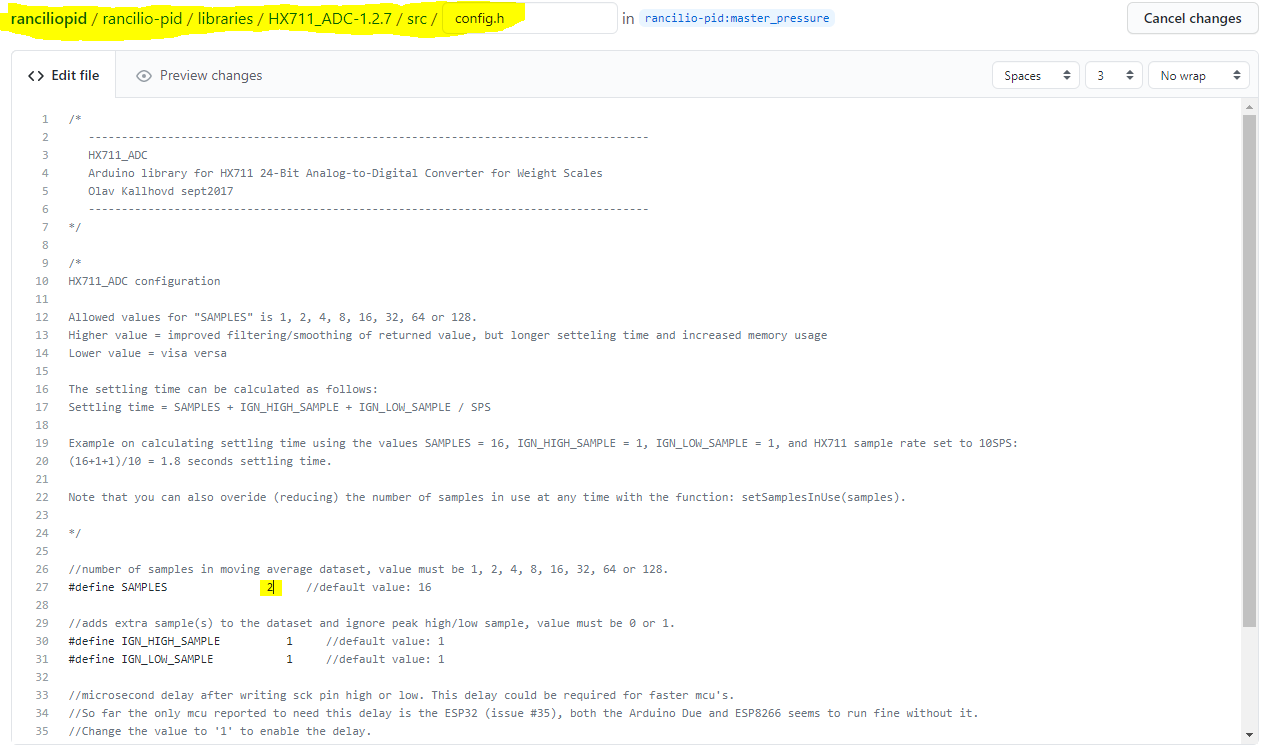
public/wp-content/uploads/2021/04/Software_3.png
