clevercoffee/clevercoffee-docs/public/wp-content/uploads/2021/04/userconfig_Hardware-150x150.png

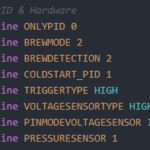
public/wp-content/uploads/2021/04/userconfig_Hardware-150x150.png
