clevercoffee/clevercoffee-docs/public/3d-designs/Case Gaggia.stl

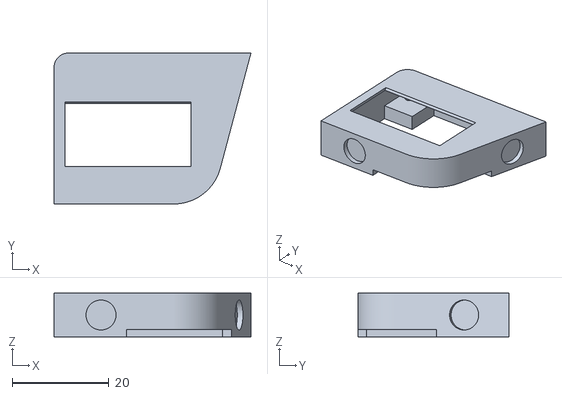
[picture p93: CAD file, 2025-01-19]
public/3d-designs/Case Gaggia.stl
40.7 x 31.2 x 9.00
