clevercoffee/clevercoffee-docs/public/3d-designs/Case Rancilio.stl

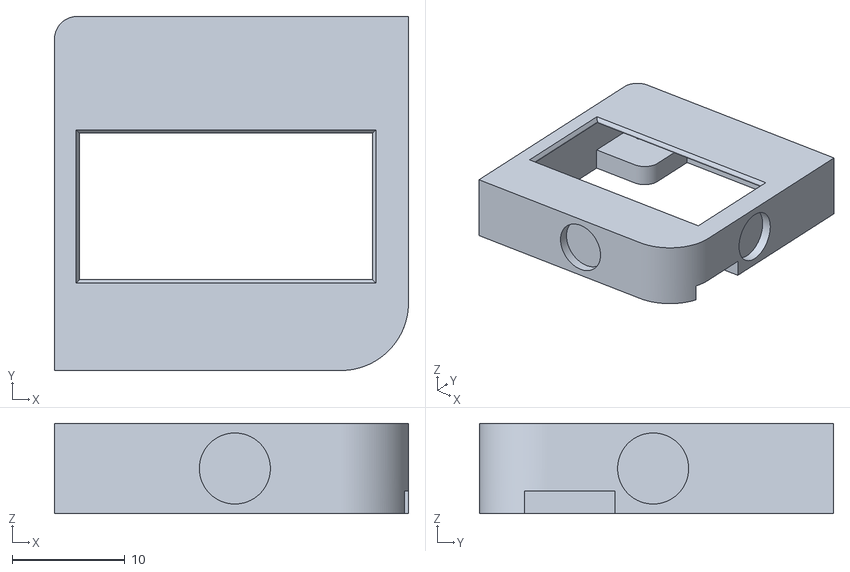
[picture p94: CAD file, 2025-01-19]
public/3d-designs/Case Rancilio.stl
31.4 x 31.4 x 8.00
