clevercoffee/clevercoffee-docs/public/3d-designs/Einbauanleitung.pdf

# Schritt 1

## Pins vom Display kürzen

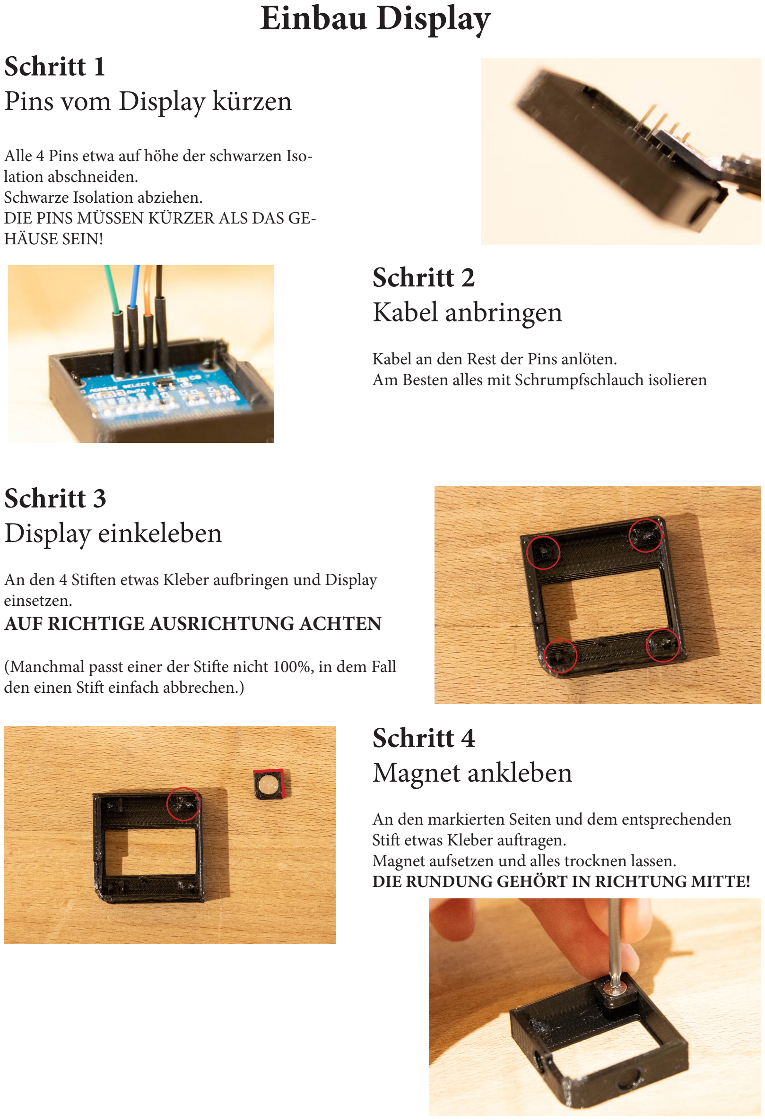
[picture p95: page 1]

Alle 4 Pins etwa auf höhe der schwarzen Isolation abschneiden.
Schwarze Isolation abziehen.
DIE PINS MÜSSEN KÜRZER ALS DAS GE-HÄUSE SEIN!

# Schritt 2

## Kabel anbringen

Kabel an den Rest der Pins anlöten.
Am Besten alles mit Schrumpfschlauch isolieren

# Schritt 3

## Display einkeleben

An den 4 Stiften etwas Kleber aufbringen und Display einsetzen.

### AUF RICHTIGE AUSRICHTUNG ACHTEN

(Manchmal passt einer der Stifte nicht 100%, in dem Fall den einen Stift einfach abbrechen.)

# Schritt 4

## Magnet ankleben

An den markierten Seiten und dem entsprechenden Stift etwas Kleber auftragen.
Magnet aufsetzen und alles trocknen lassen.
DIE RUNDUNG GEHÖRT IN RICHTUNG MITTE!

# Einbau Display
