clevercoffee/clevercoffee-docs/src/content/de/bauberichte/silvia-e-demontage.mdx

---
title: "Rancilio Silvia – Demontage"
---

# Rancilio Silvia – Demontage

Rancilio Silvia mit Manometer

## Schritt 1 – Wassertank entnehmen

Entfernen des Wassertanks.  
Dieser kann einfach herausgezogen werden. (Tipp: Legt euch einen kleinen Lappen bereit, da aus den Schläuchen noch etwas Restwasser tropfen kann.)

Tankentnahme

---

## Schritt 2 – Deckel abnehmen

Deckel abnehmen…  
Hierzu werden die 4 Kreuzschlitzschrauben auf der Oberseite der Maschine gelöst.  
Die Abdeckplatte lässt sich danach einfach herausnehmen.

Tassenablage Entfernen

---

## Schritt 3 – Rückwand entfernen

Hintere Abdeckung entfernen.  
Die Rückwand ist mit drei Schrauben befestigt. Zwei sind offensichtlich, eine ist etwas versteckt (unter dem Wassertank).  
Lockert diese Schraube (nicht ganz herausdrehen).

Rückwandschraube lockern

Bodenschraube lockern

Wenn die drei Schrauben gelöst sind, nehmt die Rückwand durch eine Kippbewegung  
von „unten-nach-hinten-nach-oben“ ab.

Rückwand herausnehmen

---

## Schritt 4 – Isolationsblech demontieren

Isolationsblech demontieren.  
Einfach die zwei Schrauben lösen, und das Blech kann abgenommen werden.

Wassertank-Blech abschrauben Wassertank Blech abschrauben

---

## Schritt 5 – Frontblech demontieren

Hierzu zwei Schrauben lösen, die Abtropfschale (Auffangwanne) entfernen und das Blech seitlich herausziehen.

Frontblech abschrauben

Frontblech entnehmen

---

## Disclaimer

> **Disclaimer**  
> Dieser Baubericht ist nach bestem Wissen und Gewissen erstellt, schließt aber Fehler nicht aus und erhebt keinen Anspruch auf Vollständigkeit.  
> Bitte denkt beim Nachbau selbst mit und seid euch der Umbauten bewusst!
