clevercoffee/clevercoffee-docs/public/img/bauanleitungen/lelit-pl41em/IMG_1451.jpeg

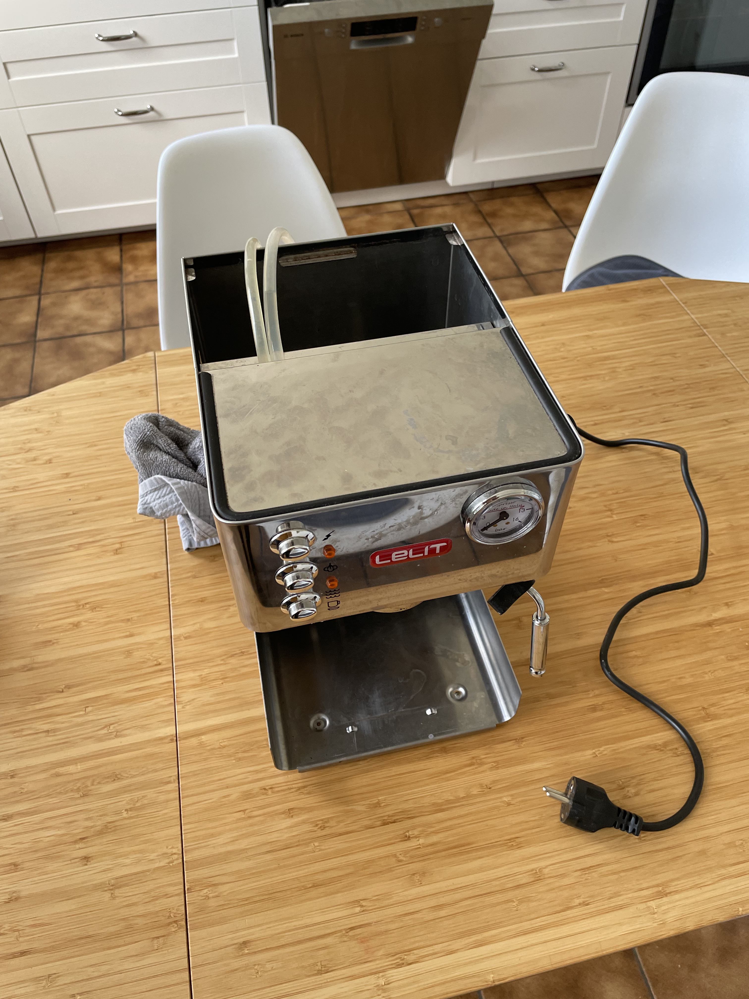
public/img/bauanleitungen/lelit-pl41em/IMG_1451.jpeg
