clevercoffee/clevercoffee-docs/public/img/bauanleitungen/lelit-pl41em/IMG_1456.jpeg

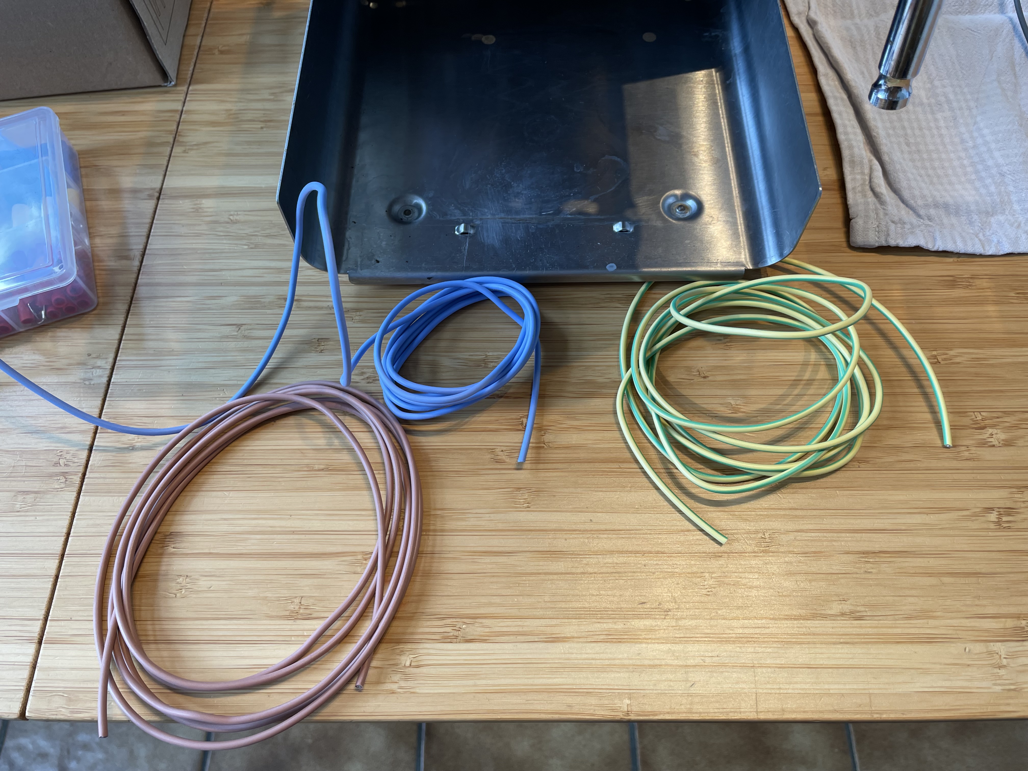
public/img/bauanleitungen/lelit-pl41em/IMG_1456.jpeg
