clevercoffee/clevercoffee-docs/public/img/bauanleitungen/lelit-pl41em/IMG_1468.jpeg

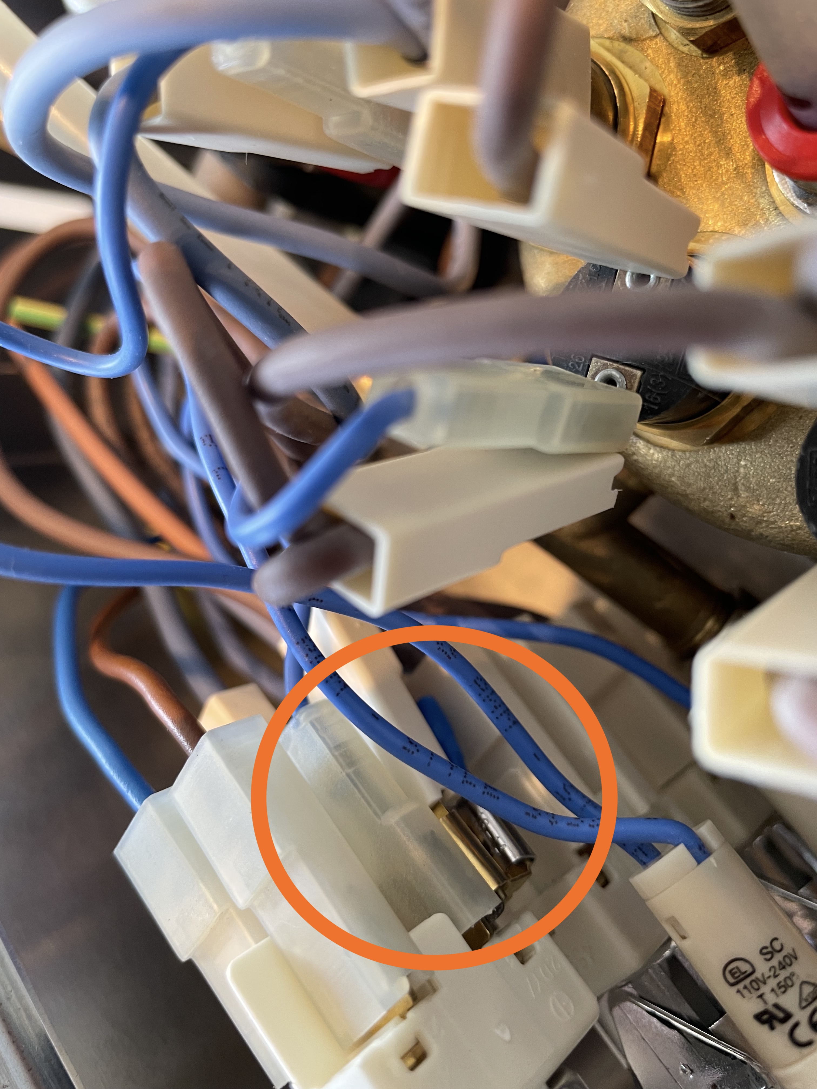
public/img/bauanleitungen/lelit-pl41em/IMG_1468.jpeg
