clevercoffee/clevercoffee-docs/public/img/bauanleitungen/lelit-pl41em/IMG_1472.jpeg

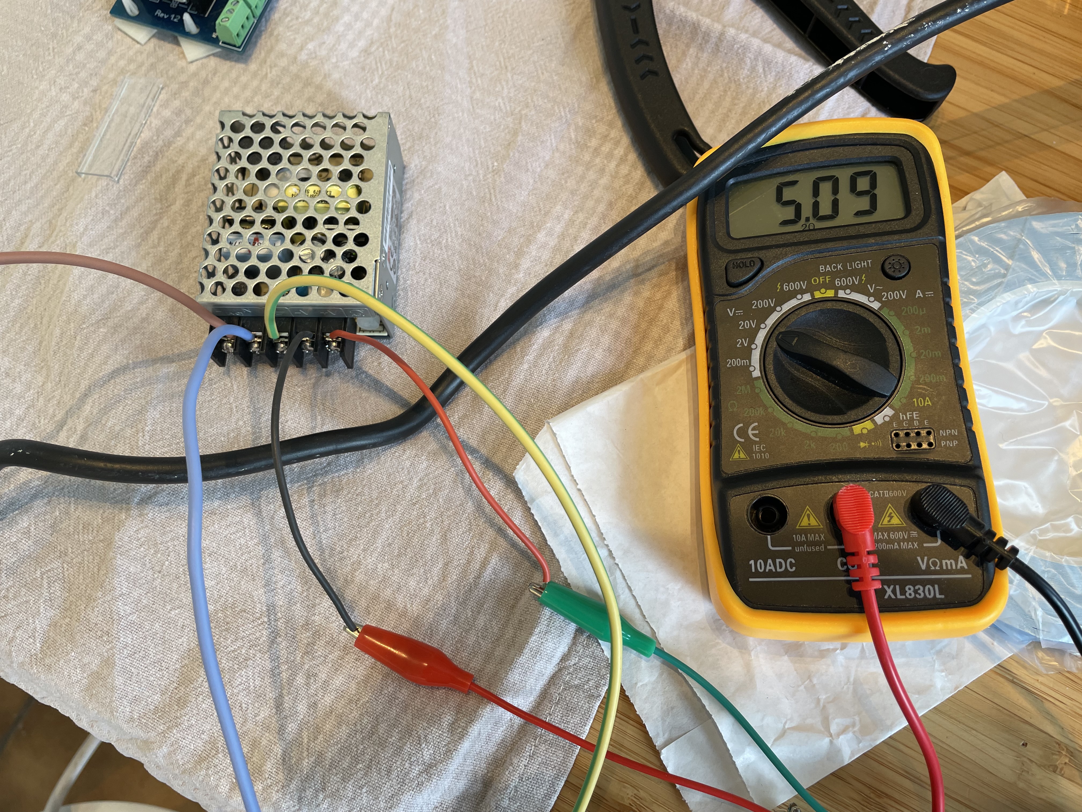
public/img/bauanleitungen/lelit-pl41em/IMG_1472.jpeg
