clevercoffee/clevercoffee-docs/public/img/bauanleitungen/lelit-pl41em/IMG_1478.jpeg

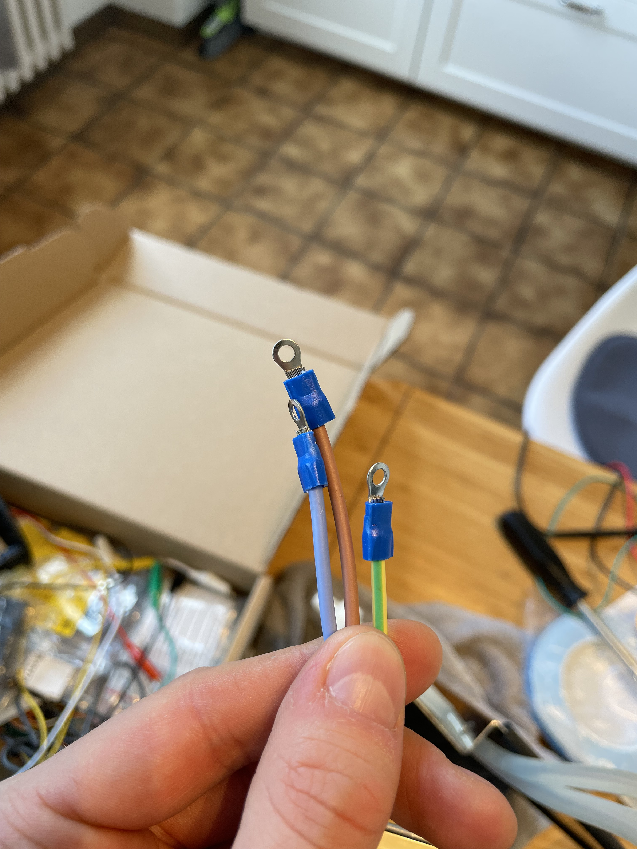
public/img/bauanleitungen/lelit-pl41em/IMG_1478.jpeg
