clevercoffee/clevercoffee-docs/public/img/bauanleitungen/lelit-pl41em/IMG_1489.jpeg

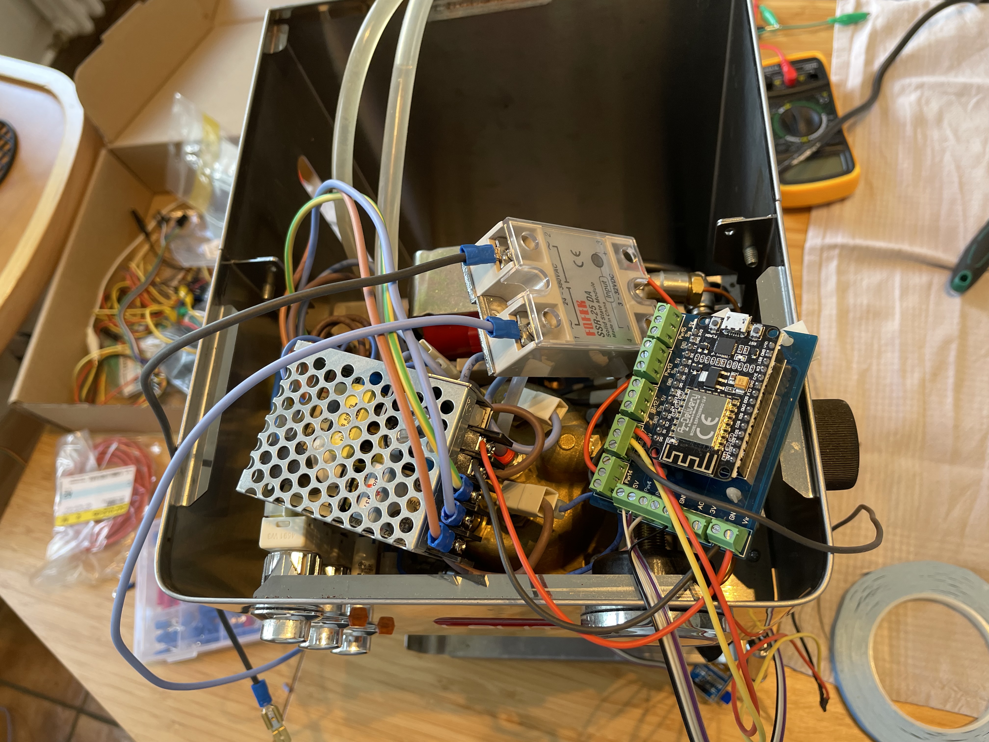
public/img/bauanleitungen/lelit-pl41em/IMG_1489.jpeg
