clevercoffee/clevercoffee-docs/public/img/bauanleitungen/lelit-pl41em/IMG_1490.jpeg

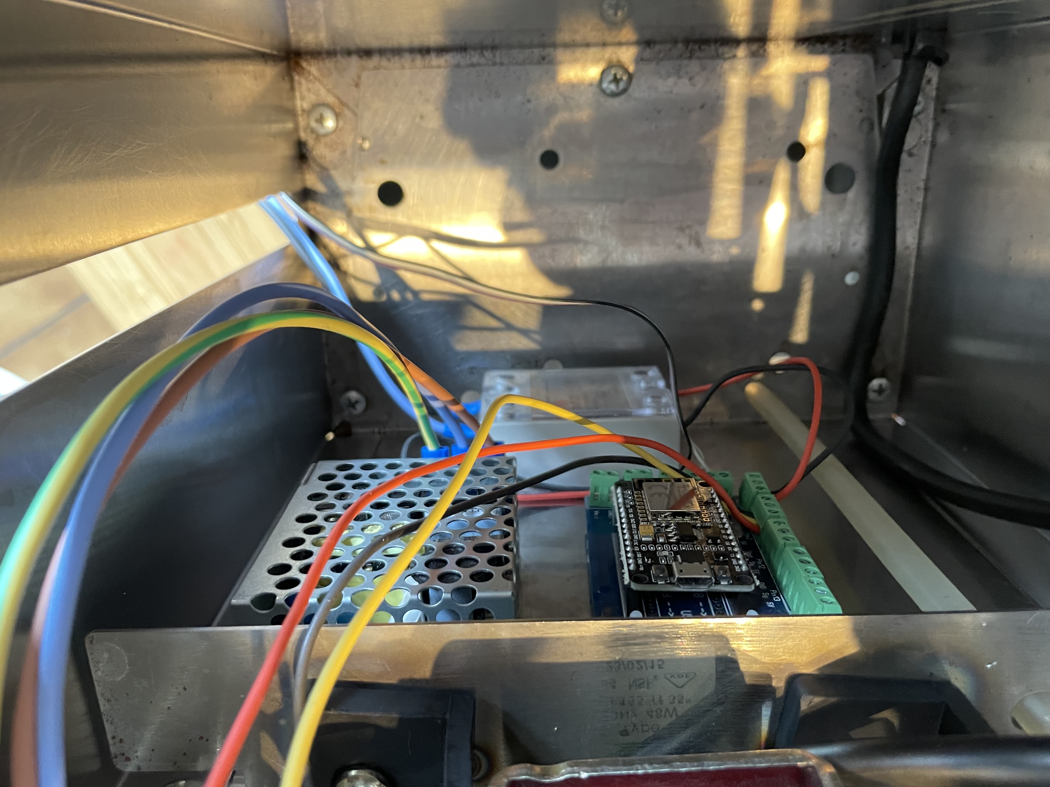
public/img/bauanleitungen/lelit-pl41em/IMG_1490.jpeg
