clevercoffee/clevercoffee-docs/public/img/bauanleitungen/lelit-pl41em/IMG_1495.jpeg

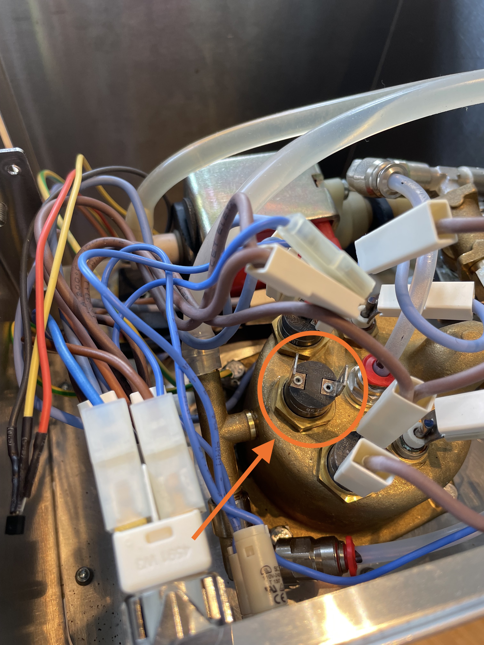
public/img/bauanleitungen/lelit-pl41em/IMG_1495.jpeg
