clevercoffee/clevercoffee-docs/public/img/bauanleitungen/lelit-pl41em/IMG_1496.jpeg

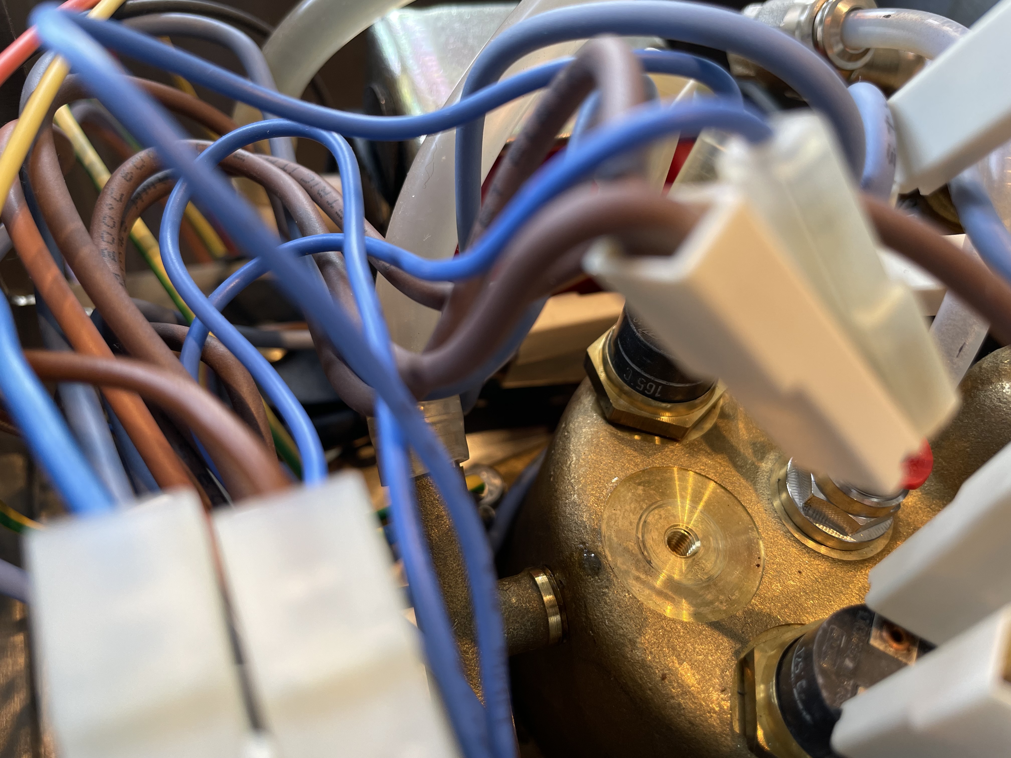
public/img/bauanleitungen/lelit-pl41em/IMG_1496.jpeg
