clevercoffee/clevercoffee-docs/public/img/bauanleitungen/lelit-pl41em/IMG_1506.jpeg

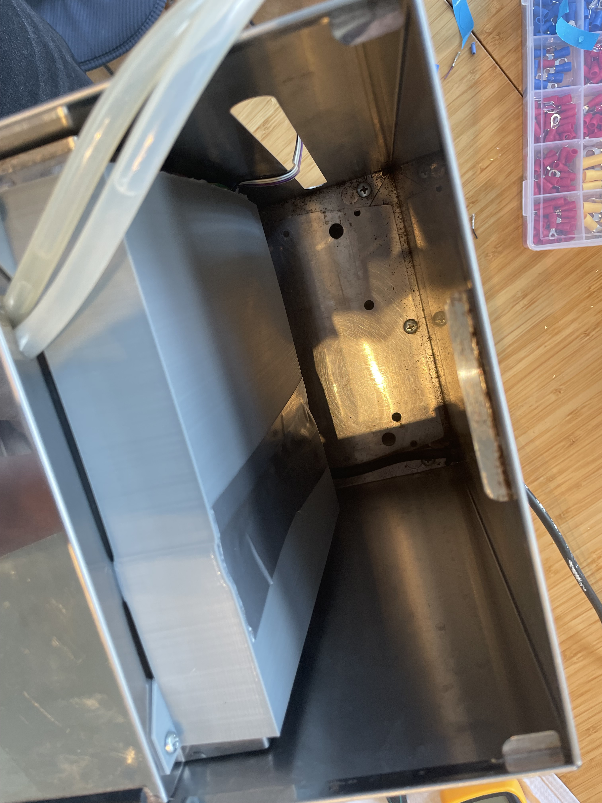
public/img/bauanleitungen/lelit-pl41em/IMG_1506.jpeg
