clevercoffee/clevercoffee-docs/public/img/bauanleitungen/lelit-pl41em/IMG_1561.jpeg

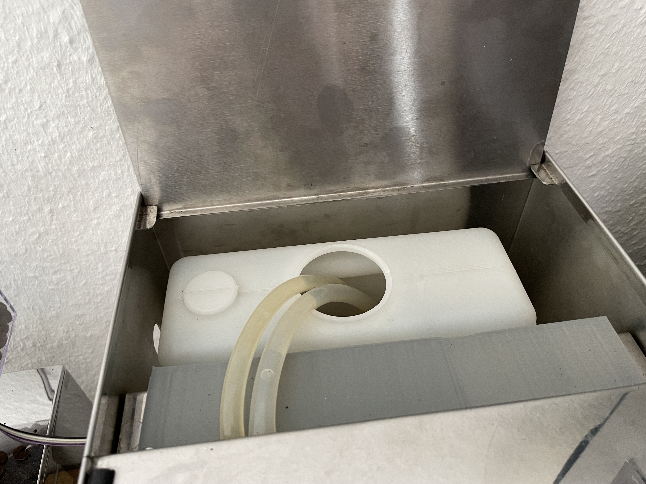
public/img/bauanleitungen/lelit-pl41em/IMG_1561.jpeg
