clevercoffee/clevercoffee-docs/public/schaltplan/Schaltplan_OnlyPID.pdf

# www.rancilio-pid.de https://github.com/rancilio-pid

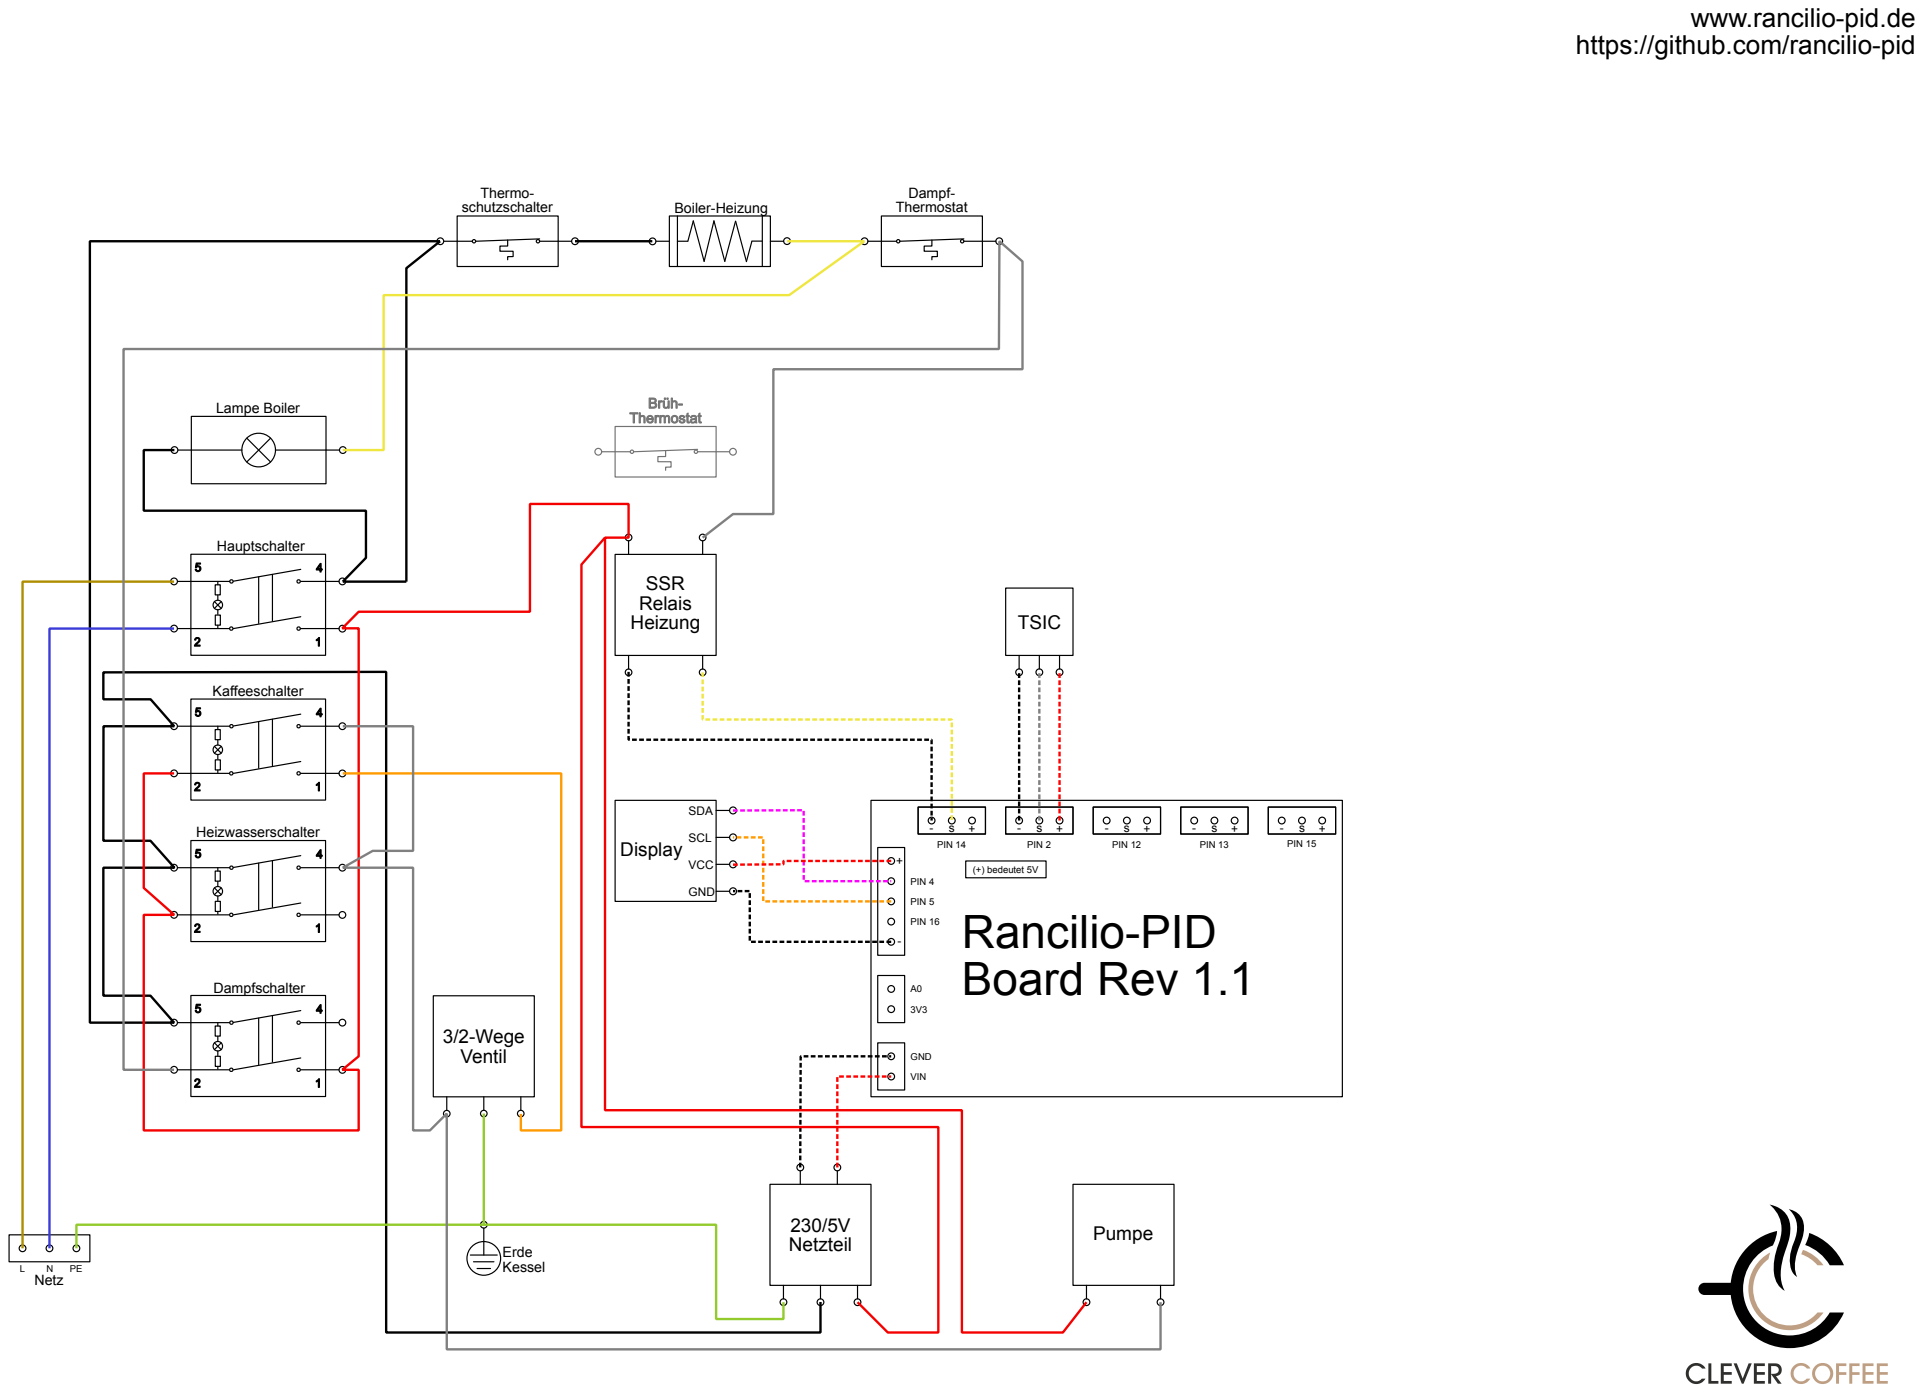
[picture p137: page 1]
Lampe Boiler; Thermo- schutzschalter; Dampf- Thermostat; Brüh- Thermostat; Hauptschalter; Kaffeeschalter; Heizwasserschalter; Dampfschalter; Boiler-Heizung; SSR Relais Heizung; 3/2-Wege Ventil; Netzteil; Pumpe; Display; SDA; SCL; VCC; GND; TSIC; + - Rancilio-PID Board Rev 1.1; PIN 4; PIN 14; PIN 2; PIN 12; PIN 13; PIN 15; PIN 5; PIN 16; VIN; (+) bedeutet 5V; Erde; Kessel; Netz
