clevercoffee/clevercoffee-docs/public/schaltplan/Schaltplan_Original.pdf

# www.rancilio-pid.de https://github.com/rancilio-pid

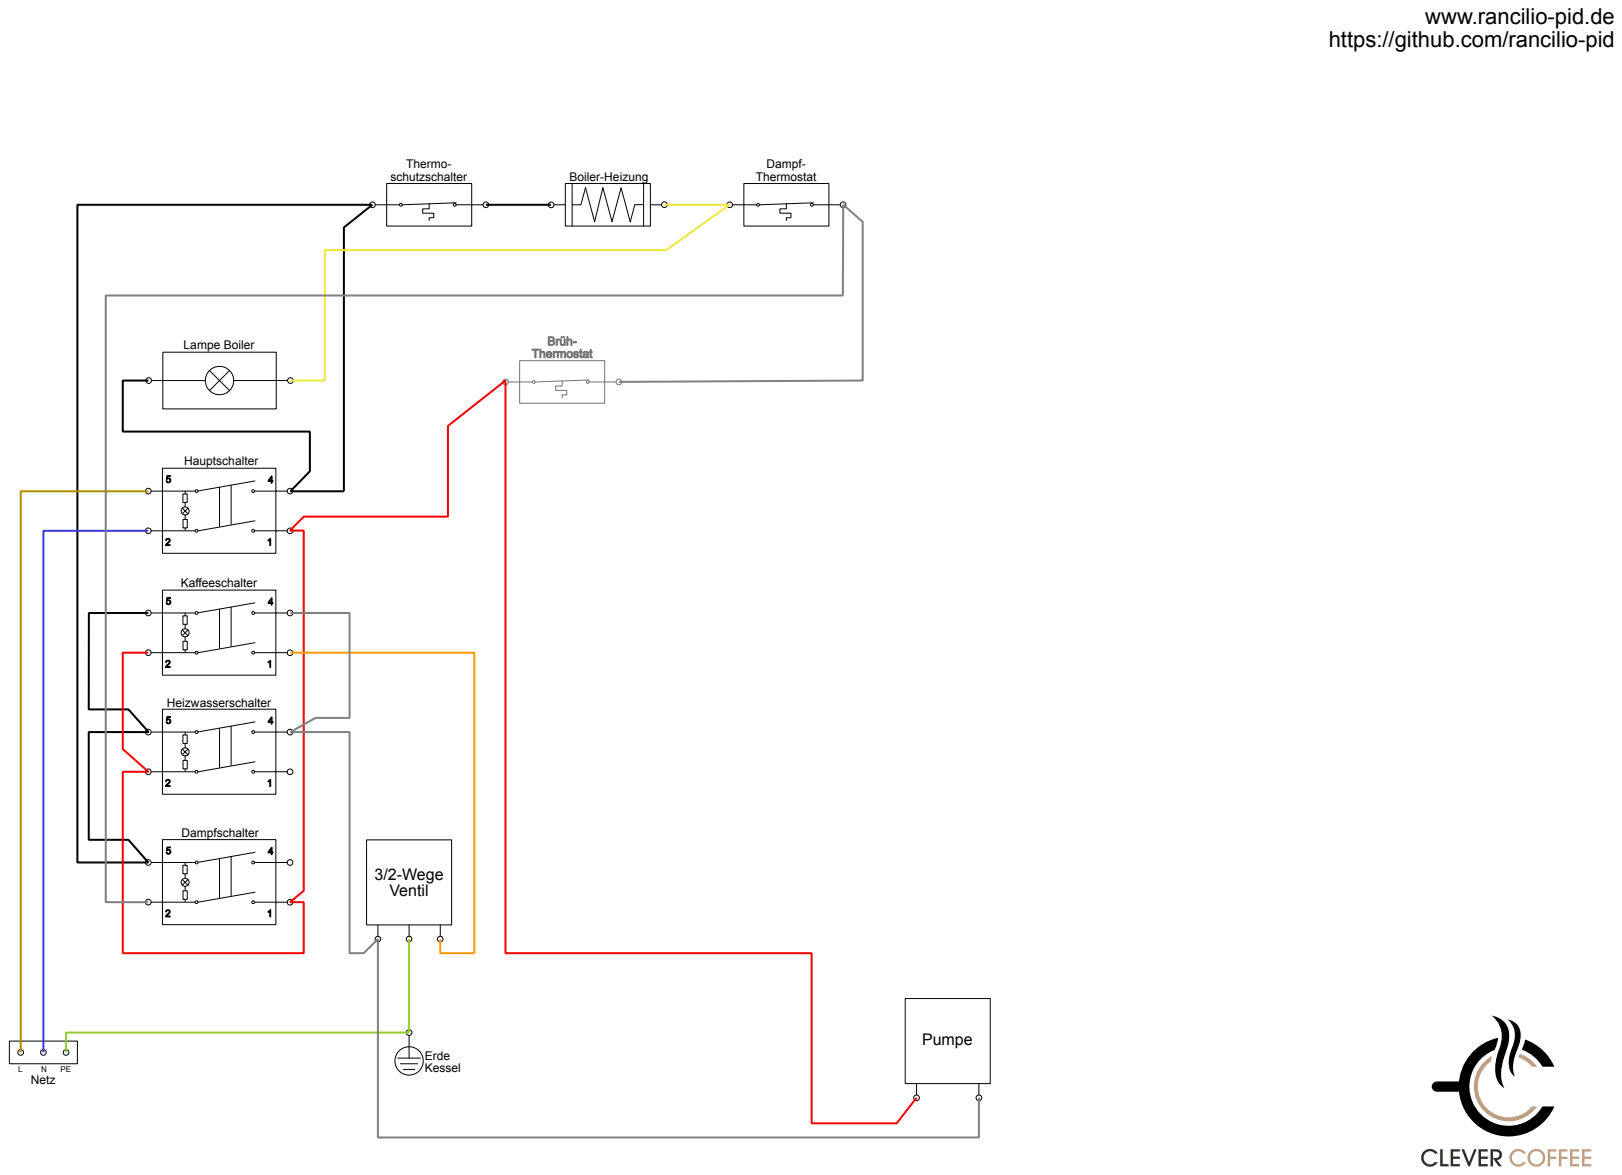
[picture p138: page 1]
Lampe Boiler; Thermo- schutzschalter; Dampf- Thermostat; Brüh- Thermostat; Hauptschalter; Kaffeeschalter; Heizwasserschalter; Dampfschalter; Boiler-Heizung; 3/2-Wege Ventil; Pumpe; Erde; Kessel; Netz
