clevercoffee/clevercoffee-docs/public/schaltplan/Schaltplan_Vollausbau1.pdf

## Relais Pumpe

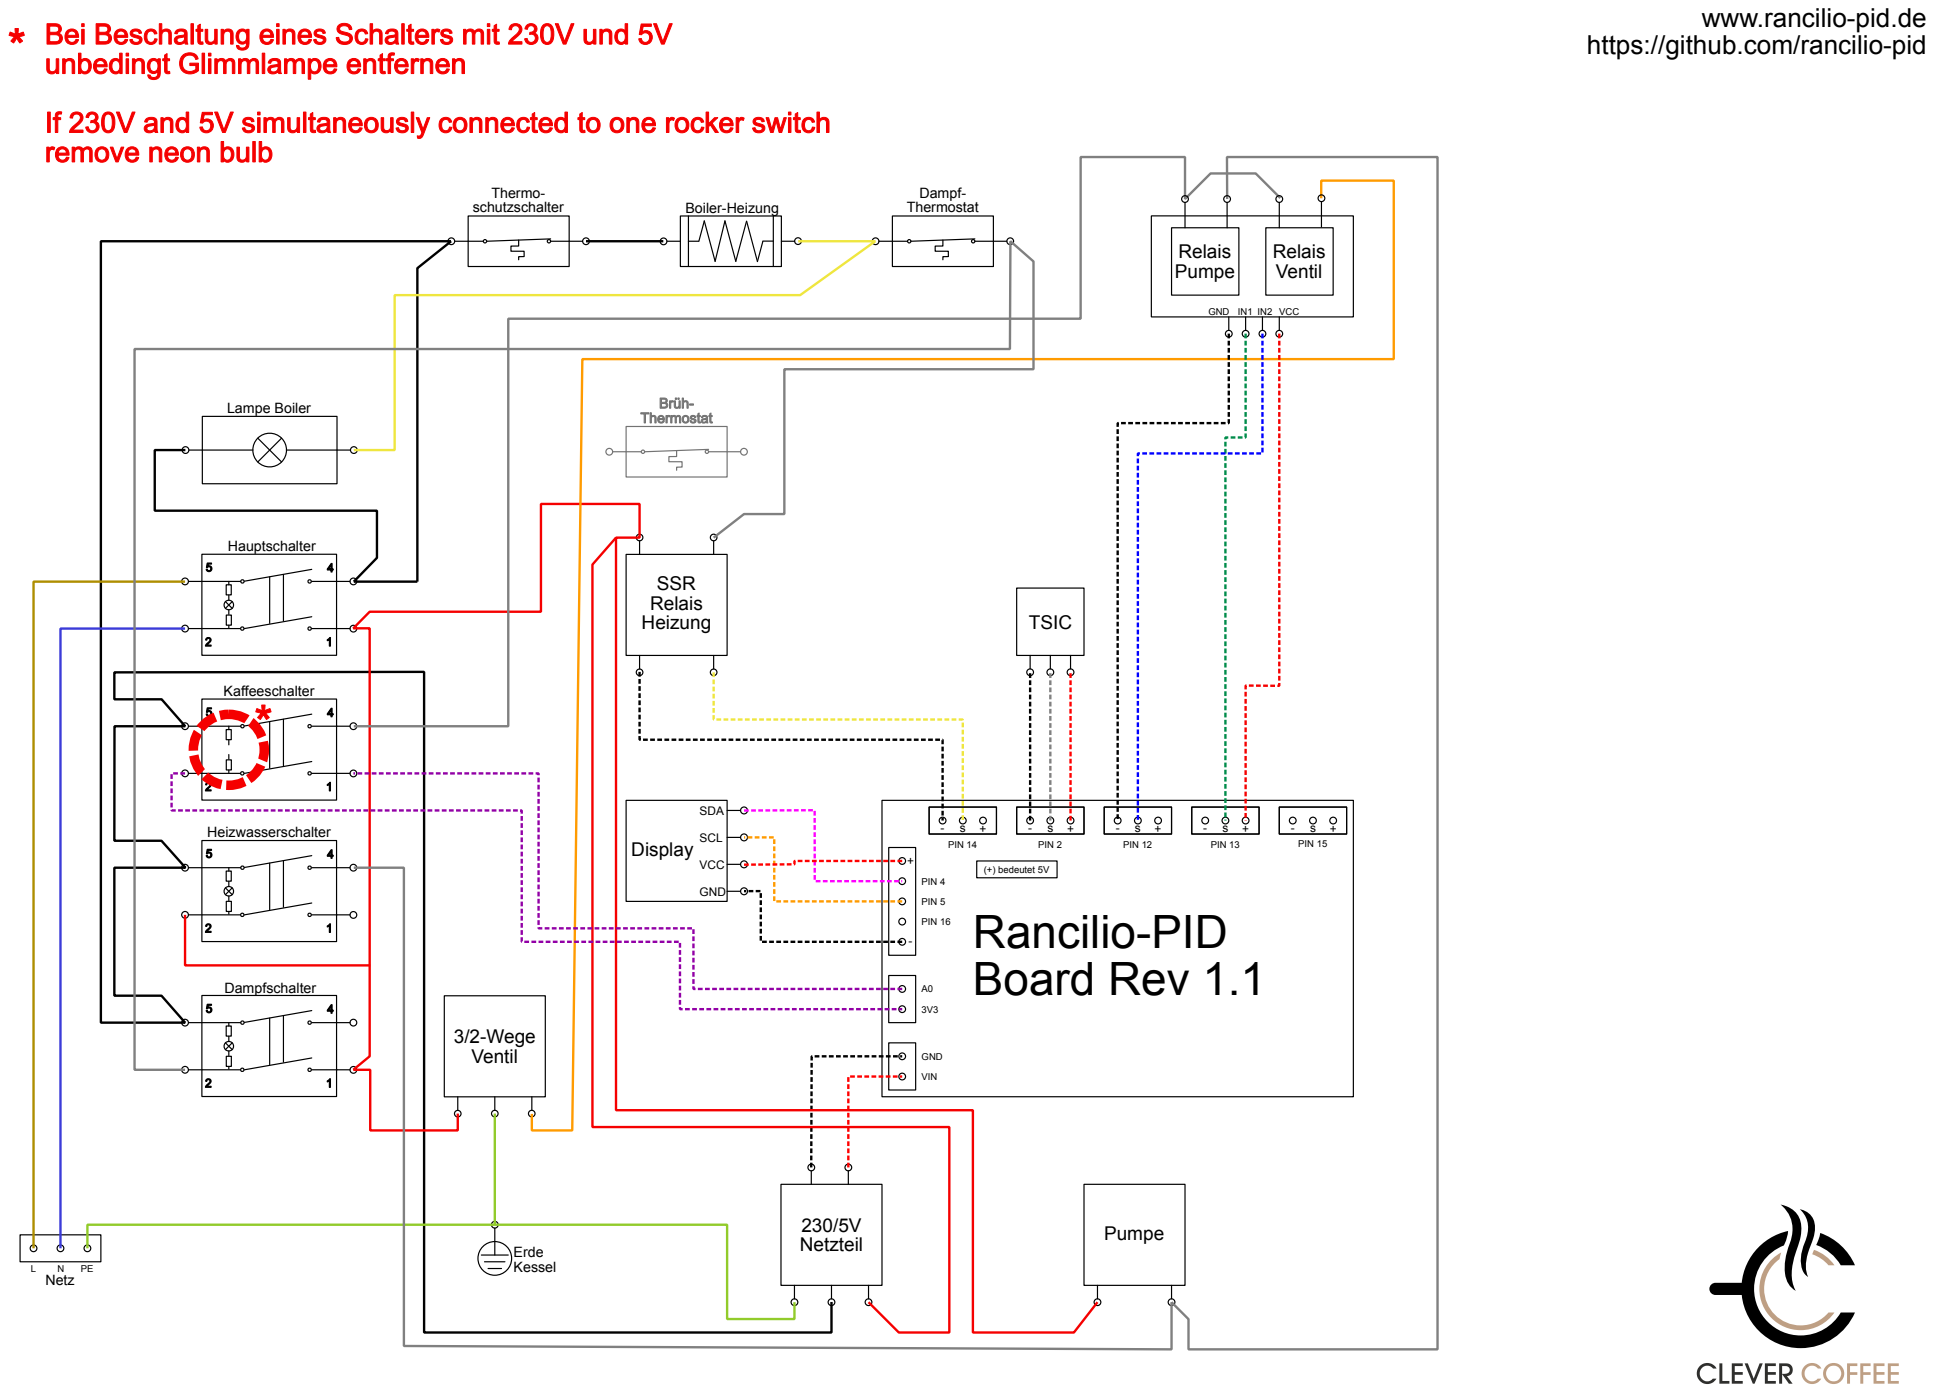
[picture p139: page 1]
Lampe Boiler; Thermo- schutzschalter; Dampf- Thermostat; Brüh- Thermostat; Hauptschalter; Kaffeeschalter; Heizwasserschalter; Dampfschalter; Boiler-Heizung; SSR Relais Heizung; 3/2-Wege Ventil; Netzteil; Pumpe; Display; SDA; SCL; VCC; GND; TSIC; + - Rancilio-PID Board Rev 1.1; PIN 4; PIN 14; PIN 2; PIN 12; PIN 13; PIN 15; PIN 5; PIN 16; VIN; (+) bedeutet 5V; Erde; Kessel; Netz; Relais Ventil; GND IN1 IN2 VCC

www.rancilio-pid.de

Bei Beschaltung eines Schalters mit 230V und 5V
unbedingt Glimmlampe entfernen

https://github.com/rancilio-pid

If 230V and 5V simultaneously connected to one rocker switch
remove neon bulb
