clevercoffee/clevercoffee-docs/(commit log)

2025-01-19 Initial Nextra setup by cellcortex
    [Case Gaggia.stl, Case Rancilio.stl, lelit_schutzplatte.scad]
2025-01-25 layout improvements
    - add formatting to high voltage caution
    - banner to refer to beta state of documentation
    - fix github action to use master branch instead of main
2025-01-25 add kicad reference, update nextra
2025-01-25 add basepath to kicad import
