clevercoffee/clevercoffee-docs/public/img/bauanleitungen/lelit-pl41em/IMG_1463.jpeg

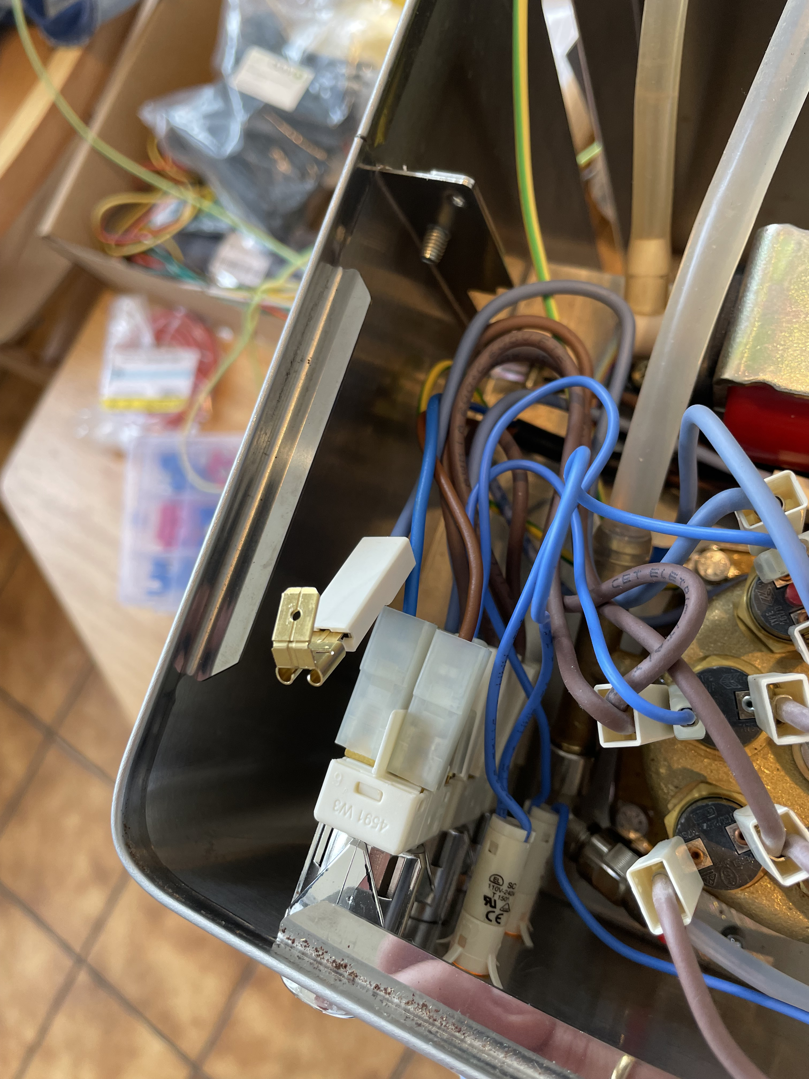
public/img/bauanleitungen/lelit-pl41em/IMG_1463.jpeg
