clevercoffee/clevercoffee-docs/public/img/bauanleitungen/lelit-pl41em/IMG_1476.jpeg

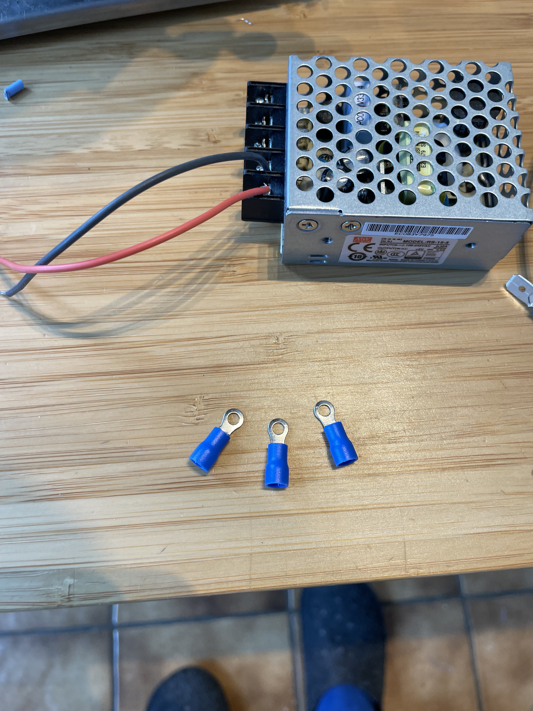
public/img/bauanleitungen/lelit-pl41em/IMG_1476.jpeg
