clevercoffee/clevercoffee-docs/public/img/bauanleitungen/lelit-pl41em/IMG_1488.jpeg

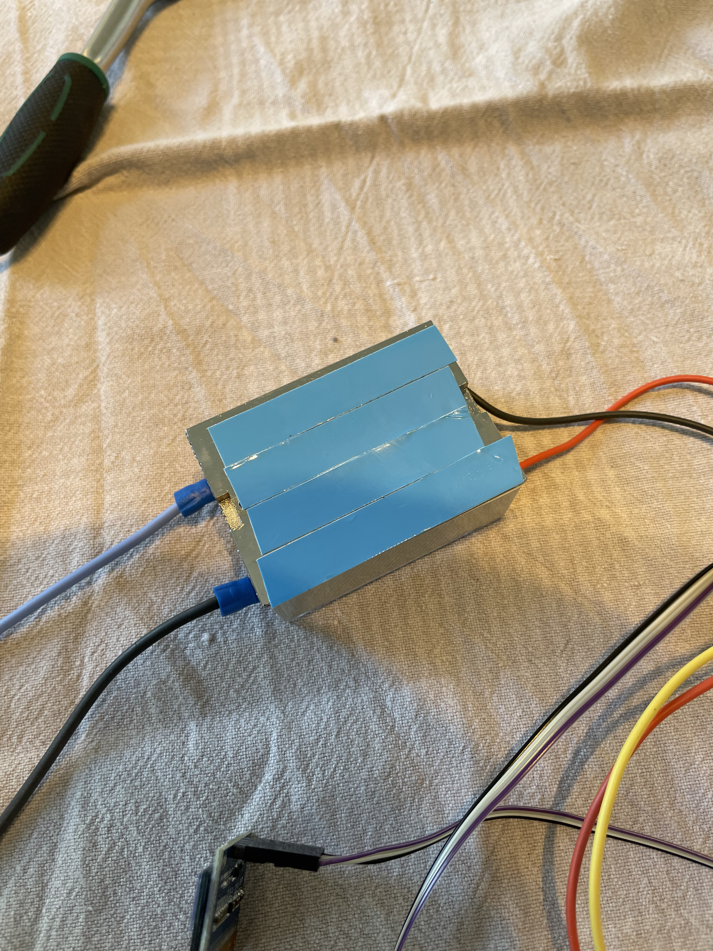
public/img/bauanleitungen/lelit-pl41em/IMG_1488.jpeg
